Seroliya/zqcs-team-robotics/供电接线图.png

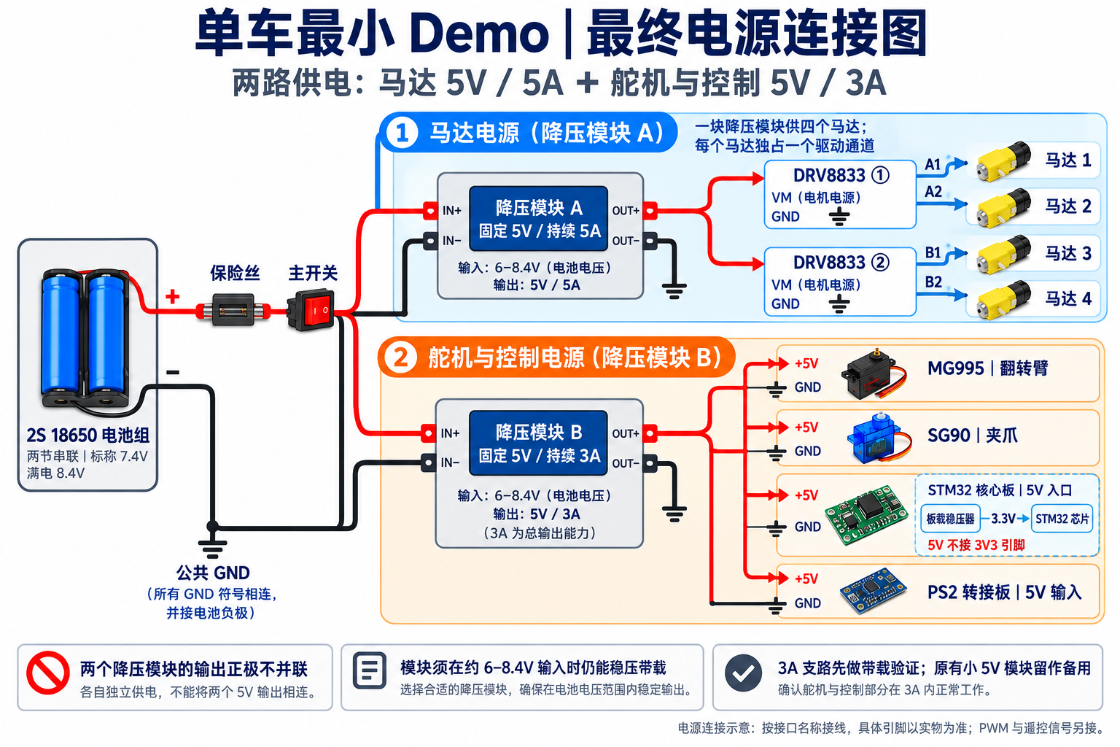
供电接线图.png
