Seroliya/zqcs-team-robotics/tmp/sources/image2.png

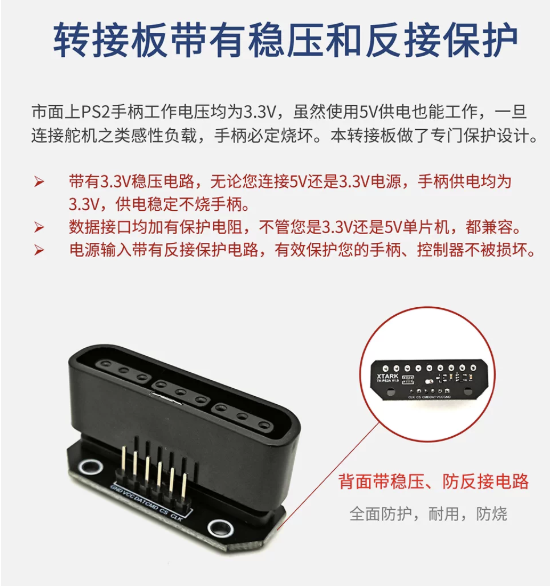
tmp/sources/image2.png
