Seroliya/zqcs-team-robotics/PROJECT.md

# CRTC2026 小车项目

本文件是本项目的长期记忆，记录当前目标、已采用方案、依据、待验证事项与继续工作的入口。团队已确认参加**新生组**，采用**上层车推送、下层车收集**的分工；先验证基础行驶与关键机械路径，再分别完善两辆车。

**2026-10-03 最终双F103分工（未改固件/未烧录）：**用户纠正为“一块32控制两个驱动板”：A主控仅读PS2与处理其他控制，经USART2 PA2/PA3交叉向B底盘发送四轮目标；B一块F103C8T6控制两TB6612双路板和四MG370全部通道。此前把两F103各控制两电机理解为用户选择，是误解，原图文已被替换。用户随后明确选择13PPR霍尔：底盘M1左后编码器TIM2 PA0/PA1、M2右后TIM3 PA6/PA7、M3左前TIM1 PA8/PA9（均4倍计数），M4右前PB10/PB11，A相EXTI10双边沿2倍计数；各轮按独立counts_per_rev换算。TIM4 PB6–PB9输出四PWM；方向分别PB0/PB1、PB3/PB4、PB5/PB12、PB13/PB14，PB15共控两驱动STBY；PB3/4须关闭JTAG保留SWD。主控PS2 PB12–PB15，可选TIM4 PB6–PB9四舵机PWM，传感器预留I2C2 PB10/PB11；两板同名GPIO互不冲突。电池暂保持原两串18650，升压12V；独立5V供两核心板5V输入及PS2，B.3V3供两驱动VCC，两板3V3不互并、所有GND共地。用户升压截图7.4→12V仅1.5A，小于四MG370额定工作点4.4A，TB小板电流/散热也不足；控制资源方案可行，动力升压需更换、驱动需升级或受控验证，电池/电池盒能力未核实。四节2S2P只是后续询问备选，电压仍7.4/8.4V，不表示正式采用。新规划替代旧单板8PWM接线，见[接线说明](sample-mecanum-car-study/docs/DUAL_F103_CHASSIS_WIRING.zh-CN.md)及[逐接口信号图](sample-mecanum-car-study/docs/figures/dual-f103-signal-ports-20261003.png)、[逐接口供电图](sample-mecanum-car-study/docs/figures/dual-f103-power-ports-20261003.png)。当前固件仍旧TT开环，未实现新编码器/PID/通信/使能；TB标准PWM低电平短路制动，不能照搬旧双输入PWM的00滑行停车。本轮仅提交图片与方案文档，未改固件或烧录。

**2026-10-03升压候选复核：**新截图标称30W MAX、输入9A MAX，芯片型号未确认。12V下按30W预算最多2.5A，不能覆盖四MG370标称额定工作点52.8W/4.4A；两块分别供两电机时每组26.4W，只剩3.6W最大功率余量，持续输出、低电压、起步和温升均待验证。两升压输出不得直接并联，TB6612电流/散热瓶颈独立存在。图中升压保持选型待核；并未决定采购。两张图用矩形模块逐接口表达，并保留SVG、生成脚本及端口清单。

**2026-10-02历史单板草案（已被10月3日双板方案替代）：**用户希望整车约2kg爬坡，允许更换平台、轮子与供电，优先整套性价比；本次明确按两块普通TB6612FNG双路板规划，电机为尚未购买的MG370。ADB手机截图确认所看商品为12V、减速比34.014、额定1.1A/1.5kgf·cm/260rpm、堵转6.2A、96g，两种霍尔/GMR版本同表，实际编码器选项未确认。两TB电压/逻辑可接，但连续负载散热和电流余量不足，未认定为2kg爬坡匹配；普通XL6009不作为四轮升压动力首选。新接线规划见[MG370与两TB接线](sample-mecanum-car-study/docs/MG370_TB6612_WIRING.zh-CN.md)：沿用现有8路双输入PWM，TB的PWMA/PWMB保持3.3V高，后续PB5共控STBY需新增代码；四轮低线数霍尔拟用A相EXTI、B相判方向，PB3/PB4需释放JTAG保留SWD，PA11/PA12占用USB数据且需检查板载上拉。预留PA4/PA5 ADC、PA9/PA10 UART、PB6/PB7 I2C舵机扩展。GMR不能未经脉冲率核算直接套此中断方案。当前板上仍为原DRV8833/TT开环麦轮固件，未加入编码器/PID/舵机或PB5使能，未烧录；胶轮需改混控，换电机需重验极性和弱反转急停。

**MG370供电规划补充（延续两串升压路线）：**用户随后明确当前路线是两节18650串联升压到12V，再接两块TB6612的VM；三串电池仅为备选，不替代用户选择。主控/PS2从电池支路降压5V，TB逻辑VCC及PWMA/PWMB保持3.3V。按四只MG370商品额定1.1A预算，12V输出需要4.4A/52.8W，两串7.4V、效率85%时输入约8.39A，尚不含起步及外围；普通XL6009的4A开关电流不意味着可输出12V4.4A，因此升压路线可以规划，但具体模块与两TB负载能力均未验收。接线文档已按两串升压主方案更新。

**当前阶段：结构、供电与信号接线设计。尚无已验证的整车或正式加工图；已有固件源码与构建入口。** “最终电源图”表示本轮讨论选定的连接方案，不表示已经通过实物测试；信号图为建议引脚分配。

**本次版本整理与PR已完成：**本地开发分支`local/chassis-tuning-20261002`，四个底盘版本检查点及基础版标签已建立；当前已烧录固件对应`chassis/scurve-stop-20261002` / `c14c55a12e232da9e4421bd50c9f4b458ddf6aa5`，从该提交重新编译与板内11220字节读回一致，四份登记HEX也逐份校验通过。开发分支已推送Ehicy/zqcs-team-robotics fork，最新[PR #2](https://github.com/Seroliya/zqcs-team-robotics/pull/2)面向Seroliya主仓库main，创建时open、非draft、可合并，尚待审核。GitHub连接器创建PR返回集成403，随后使用本机Git现有GitHub认证创建成功，未输出或保存凭证。PR已附到本任务，操作与回退见[版本索引](sample-mecanum-car-study/docs/LOCAL_VERSIONS.zh-CN.md)。用户已得到可以接回VM试车的说明；本次不再暂停/复位板子，起步和急停实车效果待反馈。

**当前11220字节固件已烧录并独立校验（2026-10-02）：**用户要求曲线起步，明确选择松杆和START都反向急停。恒定满幅0.5s五次S曲线，小幅按比例缩短、最低80ms，公共斜率限幅375；行驶增幅200/减幅1000，直接换向先零输出等待40ms。正常模拟帧急停撤驱动20ms，再按此前PWM相反方向的10%输出，名义窗口30ms，最后输入1/1短路制动100ms；此前最大PWM低于30%只制动，静止无脉冲，重复请求不延长，错过窗口跳过。数字/无效帧、非法值、上限0和Flash操作前直接0/0；START需制动结束且松键回中再启动。保留25/50映射、前100/后95及v2校准。没有测速/电流反馈，不是真PID；主循环推进时间，没有独立硬件关断，调试暂停可能保持PWM。主机测试和Arm GNU构建通过，BIN11220字节、静态RAM216字节，SHA256 `85176ba39d1296b4b057c45fa87d599adbf466edaceac04dd54cf99cb250b4cd`。用户确认两块VM断开后，ST-Link37FF71064E57343655231443以100kHz NORMAL/SWrst备份64KiB，与上一版10036字节前缀相同；下载Verify、复位运行、独立读回11220字节完全一致。读回时0x41/ready0、72MHz、前100/后95、cap100、四轮目标/软件输出和八路CCR全0，stop idle/startup inactive；校准页旧v1两记录保留且未加载，loaded0/dirty0，前后页字节一致，最后-run已恢复。用户随后按MODE并回中，但补充HOTPLUG未检测到ST-Link，不把切换后0x73当已确认。已告诉用户可以测试、先关电源接回VM再上电，不继续暂停板子。固件`sample-mecanum-car-study/build/s-curve-brake/`，证据`backups/curve-stop-20261002-01/`，说明[S曲线与急停](sample-mecanum-car-study/docs/S_CURVE_STOP.zh-CN.md)。停车效果、电流温升待实测。用户要求整理以前的东西为本地版本管理：已从备份恢复7260、9820、10036字节三版源码，并逐版重新编译与旧BIN逐字节一致，建立chassis/openloop-20261002、chassis/learn85-100-v1-20261002、chassis/pad100-95-v2-20261002标签。当前S曲线版在local/chassis-tuning-20261002分支，标签chassis/scurve-stop-20261002；原main仍为远程已合并的31fe7ac。版本登记表含校验值、原始归档和诊断入口，见[本地版本索引](sample-mecanum-car-study/docs/LOCAL_VERSIONS.zh-CN.md)，重新编译证据在backups/local-versions-20261002-01/，四版HEX在releases/firmware。用户随后要求整理好后提最新PR，将本地开发分支推到Ehicy/zqcs-team-robotics fork并向Seroliya/zqcs-team-robotics main提PR。

**上一版10036字节固件已下载、校验并独立读回一致：**用户补充要求pad映射并搜索常规方案：查微软/Steam/WPILib及作者死区研究后采用左杆25%、右杆50%的线性+三次混合曲线（可在头文件调为0～100），左杆两轴共同增益保持死区处理后的方向，原120～136轴死区保持；无额外时间滤波。训练改为共用驱动映射，以实际横移/转向比例学习，线性横移30%进入门槛不变。256轴值和65536方向/左右杆独立性测试通过，手感未实车验收，说明见[pad映射](sample-mecanum-car-study/docs/PAD_MAPPING.zh-CN.md)。用户要求起步斜坡0.5秒，疑似横移补偿方向反了，要求调换并靠近原始状态。已改加速率200个百分点/秒、前/后横移100/95（原85/100反向缩小差值15→5）；减速1000、换向40ms保持。SELECT训练系数5→2、每次最多10→5点，普通驾驶仍不学习，SELECT+×恢复100/100。Flash记录版本升为2，旧版本1有效记录保留但不加载，避免旧85/100覆盖新默认；不在开机写默认值。全部主机测试和Arm GNU底盘构建通过，10036字节BIN/176字节静态RAM，SHA256 `6331dc87e8e58a16d7b2e40e61f22140c0537a79002a1cefb6720b259d5b5fec`。新版HEX在`sample-mecanum-car-study/build/strafe-front100-rear95/crtc-motor-front100-rear95.hex`；源码前后快照在`backups/strafe-near-baseline-20261002-01/`。用户回复“好了”确认VM隔离后，ST-Link37FF71064E57343655231443以100kHz NORMAL/SWrst连接成功（NRST未接），备份64KiB旧板内，旧代码与9820字节上一版一致；旧参数页版本1已有85/100序号0及100/100序号1。下载新版Verify、复位运行，独立读回10036字节SHA一致；板上73、ready1、72MHz、前100/后95、目标/软件输出/八路CCR全0，旧页原样保留且loaded0/dirty0，没有开机写默认值。最后读回已-run恢复程序。证据在本次备份目录，待用户关电源接回VM再上电回中试车。横移改善/纯旋转偏心未实测解决，本次未提交或推送。操作见[靠近原始状态的补偿](sample-mecanum-car-study/docs/STRAFE_NEAR_BASELINE.zh-CN.md)。

**2026-10-02 台架进展：**轮位和后轮极性已由用户逐轮确认，PS2程序已实测；较早已烧录摇杆连续调PWM、缓加减速和换向零输出等待的底盘固件。用户实机反馈前后正常，纯横移伴随圆弧转弯、车尾靠圆心，左/右移转弯方向相反，横移尚未通过；架空纯左移时左前/右后前进、右前/左后后退，四轮转向均符合且均在转。滚子安装与实际轮速/接地差异仍待核对，不能当作仅需反转横移符号。电流温升、起转阈值及右杆旋转验收结果尚未记录。操作和下载证据见 [TT开环调优说明](sample-mecanum-car-study/docs/MOTOR_TUNING.zh-CN.md)；本次电机支路改接两串电池的决定见4.1节补充，旧5V电源图不能作为本次VM接线依据。

**同日上一版固件已上板：**用户要求推测横移补偿、人工纠偏学习和Flash保存，确认没有IMU/编码器/模拟采样，又反馈手感黏糊。前/后轴横移默认85/100，加减速500/1000个百分点每秒、40ms换向零输出等待；只在SELECT纯横移训练时从人的小幅右杆纠偏学习，普通驾驶不学习，每次SELECT训练最多10个百分点。停车回中2s后保存，两次尝试间隔至少30s；START保留校准，SELECT+×恢复100/100。主机测试、Arm GNU三目标构建通过；最新9820字节BIN/176字节静态RAM已经ST-Link下载Verify、复位运行，独立读回一致（SHA256 `e63d2d344055c2d1e3ef1119b3c49d9bdac6eb4b5283ced4ea662627bd730ab8`）。板上模式73、回中使能1、72MHz、八路CCR全0。用户按SELECT+○后，F800页有序号0的CRC有效85/100记录，复位后loaded1/dirty0、参数相同、四轮软件输出0；实板写入与复位加载通过，保存的是试验默认值，尚未做实车学习或写入中断电测试。最新操作见 [人工辅助横移学习](sample-mecanum-car-study/docs/DRIVER_CALIBRATION.zh-CN.md)。烧录时用户仅断VM、主控与接收器仍供电；下一步关电源接回VM再落地比较横移，学习收敛、电流温升待实测。改动仍在本地未提交。

**本轮ST-Link诊断证据：**初始无法获取核心ID，用户重新插紧后100kHz NORMAL/SWrst连接成功，NRST未接；之后HOTPLUG正常。下载前64KiB备份识别了7260字节旧开环版（500ms起步/80ms等待），主循环平均12.68ms，未见停滞。先前整机断电、手柄未配对时模式0；用户说明电源上电后可配对，热读取确认73帧、回中127/128，不能把无供电/未配对状态当作代码错误。旧版和新版RAM地址不同，已分别使用匹配ELF。旧版诊断归档 `backups/stlink-research-20261002-01/`；最新烧录前备份、新源码和固件、下载校验、独立读回、参数页和复位证据归档 `backups/driver-calibration-flashed-20261002-01/`，见 [ST-Link诊断](sample-mecanum-car-study/docs/STLINK_RESEARCH_2026-10-02.zh-CN.md)。

用户进一步确认SELECT+○保存测试看到了双闪，保存LED提示已目视通过。当前待用户接回VM后的落地试验；烧录时已恢复程序运行，不继续在电机供电状态下暂停调试。

**上一版落地反馈（本版实车尚待测试）：**用户确认没有SELECT训练，只推右杆且左杆回中时绕车尾旋转，横移时车头偏移比之前更严重。85/100试验补偿未得到支持，先建议SELECT+×恢复100/100作为比较基线；不要继续以“前轴作用偏强”当作事实。源码纯旋转在横移为0时不使用front/rear横移参数，四轮机械目标为左侧同向、右侧反向且同幅；故纯旋转偏心不能归因于这项85%比例。实际轮速、滚子布置/几何和接地仍未测量，需整车俯视图及持续旋转现象确认，不能直接猜旋转增益。最新ST-Link尝试显示No debug probe detected，未读取新的参数，不推断板上已发生学习。随后已按用户要求改为100/95并加入轻度摇杆曲线，最新烧录状态见本文件顶部；此前100/100恢复确已保存版本1记录，但未记录该状态的实车比较结果。

后续工作先读本文件。用户的新指示优先；比赛约束以本地规则原文及后续官方修订为准。旧设计文档与本文件冲突时，使用本文件中的当前方案，不把历史建议恢复成要求。

## 1. 背景、目标与设计原则

- 比赛最终使用两辆车；团队成员是新手，优先结构简单、少采购、容易接线和调试。
- **上层车：**类似推土机，取消夹取与存取功能，目标是将挂架及中央黄块推落；先验证原底盘过150mm桥面的能力，再决定是否缩窄轮距，具体推板、拨片与轮组尺寸待定。
- **下层车：**保留 **MG995 翻转臂＋SG90 夹爪**的收集功能，由操作手操控接收上层掉落的黄块；接料口计划在收集仓上方安装**三面倒梯形收集网**，以较大的上口扩大接料范围并把方块导入仓口，具体尺寸待样块验证。
- 两车底盘沿用四个 TT 马达、两块 DRV8833、STM32 核心板与 PS2 手柄控制的基础方向。可复用电控与行驶验证结果，不再默认整车机械结构相同或直接复制。
- 首个上电 Demo 先打通供电与遥控行驶；同时提前验证挂架脱杆、台阶遮挡和下层接料路径。下层再验证翻臂、夹取与入槽；精确堆满 8 块不是首个 Demo 的前置条件。
- 电池尽量低置，臂根有独立承力支承；用实际负载验证稳定性，不能只凭三维外观判断可行。
- 电流规格分清“实际耗电”“堵转预算”和“电源输出能力”。不得把额外余量反复叠加成最小 Demo 的硬性采购门槛，也不得把模块商品标题当作已验证能力。

## 2. 文件与工程现状

| 路径 | 用途与状态 |
|---|---|
| [CRTC2026规则文档v1.0.pdf](CRTC2026规则文档v1.0.pdf) | 比赛约束原文；封面版本与正文版本标记有差异，引用时以具体条款为准 |
| [器材参数.docx](器材参数.docx) | 官方清单器材、参数与参考外形；清单数量不等同于已到货、已测量数量 |
| [PROJECT.md](PROJECT.md) | 当前项目记忆与决策入口 |
| [最终电源连接图](output/power/robot-demo-power-final-v1.png) | 保留翻臂与夹爪的下层车两路供电基线；上层车负载改变后须单独核对，图尚未更新 |
| [信号接线图（简洁版）](output/signals/robot-demo-signal-wiring-simple-v1.png) | 下层车接线建议；上层可复用行驶与PS2部分，舵机接口按实际机构确定；GPIO不是实物排针位置图 |
| [方块质量、导料与夹取核算](output/mechanics/block-gripping-study-v1.md) | 依据规则第13–17页的几何核算、摩擦敏感性计算、洞口与挂架取块限制；未经过实物验证 |
| [下方车底盘布局 v1](output/mechanics/lower-vehicle-layout-v1.md) | 基于255.8×149mm实物底盘的模块分区、翻转臂预留和布线方向；孔位及降压模块尺寸待实测 |
| [桥面通行试验CAD v1](output/mechanics/bridge-test-v1/README.md) | SolidWorks/STEP/STL，单段300×150mm，圆弧起拱15mm；10mm板厚及净高解释为试验假设，不是官方完整桥梁复刻 |
| [带高台试验装配 v2](output/mechanics/bridge-platforms-v2/README.md) | 两座300×300×300mm高台＋两段300×150mm试验桥，桥端升到300mm与台面齐平；SLDASM/STEP。沿用试验圆弧，不能用于官方130mm桥下净空验算，原v1保留 |
| [翻转臂与料仓CAD v2](output/mechanics/flip-arm-sw-v2/README.md) | SolidWorks零件及夹取/抬升/投料三姿态装配、STEP；夹爪为占位，安装接口及收拢姿态未定，不是整套加工完成件 |
| [舵机照片适配CAD v3](output/mechanics/flip-arm-sw-v3/README.md) | 根据pic实物尺照补MG995与SG90外形、SG90托架，修正MG995朝向及支架/底座对应孔；保留v2料仓与臂长，夹爪传动和腕部连接未完成 |
| [小车结构与接线方案.md](小车结构与接线方案.md) | **历史详细草案**；其三路供电、主动分料、9 块容量、4.8V 舵机电源及部分采购要求已被后续讨论替代。尺寸、引脚表仍仅供参考 |
| `tmp/sources/` | 文档提取、参考图片及早期三维演示检查材料；不是固件代码目录，不作为长期事实来源 |
| `backups/` | 旧文档备份，用于追溯，不代表当前设计 |

电控源码位于 `sample-mecanum-car-study/`。2026-09-24 已完成 DRV8833 电机驱动；保留 Keil/ARM Compiler 5 工程，新增 Arm GNU 构建入口，无 CubeMX 工程。详见 `sample-mecanum-car-study/docs/DRV8833.zh-CN.md`。不得把 `tmp` 中的可视化脚本当成机器人控制程序。

## 3. 必须保留的比赛边界

以下依据本地规则及前期读取结果；正式参赛前复核原文与最新答疑。

| 项目 | 约束及对设计的影响 |
|---|---|
| 初始尺寸 | 长宽高不超过 **260×190×200mm** |
| 展开尺寸 | 当前按规则允许的长宽高包络 **435×400×450mm** 路径检查，需包含机构运动范围 |
| 重量 | 上限 **2.0kg**；装载道具如何计入检录重量仍须核对官方解释 |
| 电池 | 使用 **18650**；每车一个供电模块，额定电压不超过 **7.4V**，电池组一个对外输出接口；接口之后再分两路降压 |
| 断电 | 正式比赛必须适配官方无线继电器，可遥控切断底盘电源。当前 Demo 图未画该组件，不能据此认为比赛可省略；型号和端子接法待确认 |
| 成本 | 新生组全队机器人总成本上限 **420 元**；无线继电器采购按规则例外处理。未完成当前方案的实际报价核算 |
| 桥与轮组 | 桥面约 **150mm** 宽，整车限宽 **190mm** 不等于轮子能获得桥面支撑。轮子外宽、实际接触位置与桥侧干涉都需验证 |
| 方块与携带 | 方块外形约 **40mm**，中心镂空约 **20mm**。携带要求道具随车运动；规则未明确要求封闭料仓或整车倒置后仍不掉块 |
| 对抗与强度 | 低速挤压与破坏性冲撞须区分；主动铲翻并未确认合规。正式检录包含底面朝下的跌落检查，具体按规则执行 |

料仓默认可采用**有底、带挡边的敞口结构**。不得把上盖、单向门、倒置保块当作本项目首版的强制要求。

## 4. 当前采用的电源方案

### 4.1 下层车器件与连接、上层车适用范围

下层车使用：4 个 TT 马达、2 块 DRV8833、1 个 MG995、1 个 SG90、1 块 STM32F103C8T6 核心板、1 套 PS2 接收器/转接板、1 组两节串联的 18650 电池。

本节两路供电图及两舵机电流预算作为**下层车基线**保留。上层车取消夹取与存取机构，不再默认配置这两只舵机；是否需要驱动可收起拨片的舵机尚未确定。上层保留马达与控制供电需求，待机构确定后重新核算B支路负载、模块与采购数量，不能直接照搬下层两舵机预算，也不能因取消舵机而取消主控供电。

用户已确认所查舵机工作电压为 **4.8–6V**，因此当前统一使用固定 **5V** 供电，不再要求舵机支路必须调到 4.8V。

**2026-10-02 本次台架接线覆盖：**用户认为5V动力不足，明确选择两节18650串联直接接两块DRV8833的VM（标称7.4V、满电8.4V），并接受TT超过此前所报3–7.2V范围；这不是本批TT耐压/温升验证。换接前拆除VM原5V正极线，不并接两个电源正极。STBY仍接STM32的3.3V；主控、PS2与将来舵机仍按各自规定的低压供电，不接8.4V逻辑脚。每块驱动板接一个GND即可，但电池负极、两板、主控和PS2必须共地，主控单独由ST-Link供电时也如此。用户随后反馈了实机行驶，端电压、电流和温升未测；该决定只覆盖本次测试，未将两车正式电源图与舵机预算改为已验收结果。以下5V马达支路及图为此前下层车基线。

| 支路 | 下层车原基线模块 | 负载 |
|---|---|---|
| A：马达 | **固定 5V、持续 5A** 降压模块 ×1 | 两块 DRV8833 的 VM，四个 TT 分别由四个独立 H 桥通道控制 |
| B：舵机与控制 | **固定 5V、持续 3A** 降压模块 ×1 | MG995、SG90、STM32 核心板 5V 入口、PS2 转接板 5V 输入；从模块输出处分支接线 |
| 备用 | 原有小 5V 降压模块 | 暂不接入；若共用 B 支路导致控制系统复位或掉线，再单独供控制系统 |

```text
两节 18650 串联：标称 7.4V，满电 8.4V
  正极 → 近电池保险丝 → 主开关 → 分电
                                 ├ A：5V / 5A
                                 │   ├ DRV8833① → 通道A接马达1、通道B接马达2
                                 │   └ DRV8833② → 通道A接马达3、通道B接马达4
                                 └ B：5V / 3A
                                     ├ MG995
                                     ├ SG90
                                     ├ STM32核心板5V入口 → 板载稳压 → 3.3V → 主控芯片
                                     └ PS2转接板5V输入
  负极 → 公共GND → 降压模块、驱动板、舵机、核心板、PS2转接板的GND
```

- 两个降压模块的**输入**接同一电池分电点；两个模块的**输出正极不得并联**。
- 电机的两根线接它所属 H 桥通道的两个输出端，不直接接降压模块，也不把其中一根线固定接公共地。
- 舵机和控制系统从 B 的输出端分别布线。舵机电流不经过 STM32 板、PS2 板或面包板；供电线与回流线要可靠。
- STM32 **核心板**上的额外稳压器负责 5V 转 3.3V，不能把“STM32 芯片本身”当成能直接接 5V。5V 不接 3V3/VDD 引脚。
- 器材资料写明核心板可从 5V/USB 供电，PS2 转接板有稳压功能；实际端子和板型仍须核对，不能凭示意图中的器件外观接针脚。
- 供电图描述此前5V马达基线；本次VM测试按本节10月2日覆盖说明。舵机 PWM、DRV8833 输入和 PS2 通信线见信号图及4.4节；PS2与轮位/极性已实测，整车动作和舵机尚未验收。

### 4.2 电流依据与适用范围

| 数值 | 来源与使用方式 |
|---|---|
| MG995 堵转电流 **1800mA** | 用户查得；尚未提供原始链接或实测记录，具体测试电压待核对 |
| SG90 堵转电流 **860mA** | 用户查得；同上 |
| 两舵机合计 **2.66A** | 1.80＋0.86，是采用上述数据的同时堵转预算，不是正常运行电流 |
| 控制系统预留 **0.15–0.30A** | 设计估算，未测量 |
| B 支路合计约 **2.81–2.96A** | 条件性预算：上述舵机数据适用于本机 5V 供电时才可直接使用。接近 3A，作为 Demo 试验方案，需验证动态电压与温升 |

堵转电流可用于相同电压下的最大稳态负载预算；不应把同一启动需求再重复相加。它不保证覆盖所有瞬态，也不表示器件可以长期堵转。此前 MG995 2.5A、SG90 0.8A 的估算不再作为当前预算依据。

四个 TT 的当前 5A 支路用于轻载、缓起步 Demo。前期同类 1:48 TT 参考样品在 6V 下空载约 0.16A、堵转约 1.5A；不是本批次在 5V 下的实测参数，不能直接断言比赛爬坡与顶推均足够。

DRV8833电流要按**每个H桥通道**与整板散热分别核对。TI在VM=5V、25℃条件下列出PWP/RTY封装每桥1.5A RMS、2A峰值，PW封装每桥0.5A RMS、2A峰值；这些不是任意红板双通道同时工作的保证值。本车具体封装、PCB散热、限流配置和TT实际电流仍未确认。截图所称“单板统一只有1.2A，两板共2.4A”没有对应板型依据，不采用为统一规格。5V/5A是电源供电能力，不强迫驱动板消耗5A，也不保护某个通道免于过载；四个电机分别走四个通道，不能把总电流当成流过单个通道。DRV8833有过流和过温保护，但不能据此允许长期堵转；也不能把正常启动或一次堵转直接判为必然烧毁。当前保留两板带四马达的轻载Demo方案，持续顶推能力须单独验证。

### 4.3 采购与验证原则

- 下层车沿用新增 **1 块 5V/5A＋1 块 5V/3A** 的验证方案；上层车按最终执行机构另核B支路，不再默认两车采购完全相同。采购、到货和模块具体型号均未确认。
- 要求模块在电池满电 8.4V，以及放电后约 6–6.4V 的测试条件下仍能稳定输出 5V。此处是验证区间，不是已确定的电池截止电压。
- “3A/5A”应对应模块实际持续输出条件；芯片最大开关电流、商品峰值与整板持续电流不是同一指标。
- **XL4015 官方输入下限为 8V**，不作为当前两串电池方案的默认选型；增加同款板数量不能解决输入电压不匹配。
- B 支路出现控制复位/遥控掉线时，先定位供电与接线问题，必要时启用原有小降压板单独供控制系统。A 支路实测能力不足时，才考虑拆成每块带两个马达。
- 用户选择先做Demo，再按实测决定是否额外增加滤波／储能电容；不把新增大电解电容一律列为首轮采购前提。上电前仍应核对成品驱动板已有芯片需要的外围元件：TI建议DRV8833的VM就近以至少10μF陶瓷电容接GND，VINT/VCP另有各自配套电容。系统供电图未画出这些元件不表示板上没有；缺失基本外围元件不能等出问题再补，额外储能电容是否足够也不能仅凭外观判断。
- 干扰判断区分欠压与过压：单纯短时欠压通常导致复位或通信异常，不代表烧毁；超过器件额定限制的尖峰可能造成永久损坏，不能把“最多只是STM32掉电”作为验证前提。保持共地并分别布置大电流回路，先轻载缓启停测试；出现复位、抖动或异常发热先停下定位，电压尖峰需示波器等适当测量方法确认。尚无本车瞬态测量结果。
- 电池、保护、主线或 DRV8833 限流/散热不足，不能靠增加降压模块修复。当前图不代表这些器件已验收。

### 4.4 信号接线

下层车采用[简洁版信号图](output/signals/robot-demo-signal-wiring-simple-v1.png)。上层车可复用马达与PS2信号分配，PB6/PB7不再默认接翻臂与夹爪，是否用于拨片执行机构待定。用户偏好简单、少装饰的接线图。图内各分区均连接**同一块 STM32F103C8T6 核心板**；引脚名称不表示排针物理顺序。以下分配利用芯片默认定时器映射，不启用对应定时器的引脚重映射；未确认实际核心板是否全部引出这些引脚。

| STM32引脚 | 连接端 | 信号方向／建议功能 |
|---|---|---|
| PA0 | DRV8833① AIN1 | 输出，TIM2_CH1 |
| PA1 | DRV8833① AIN2 | 输出，TIM2_CH2 |
| PA2 | DRV8833① BIN1 | 输出，TIM2_CH3 |
| PA3 | DRV8833① BIN2 | 输出，TIM2_CH4 |
| PA6 | DRV8833② AIN1 | 输出，TIM3_CH1 |
| PA7 | DRV8833② AIN2 | 输出，TIM3_CH2 |
| PB0 | DRV8833② BIN1 | 输出，TIM3_CH3 |
| PB1 | DRV8833② BIN2 | 输出，TIM3_CH4 |
| PB6 | MG995 的 S | 输出，TIM4_CH1，翻转臂 PWM |
| PB7 | SG90 的 S | 输出，TIM4_CH2，夹爪 PWM |
| PB14 | PS2 DI/DAT，接收器① | **输入**，接收器 → STM32 |
| PB15 | PS2 DO/CMD，接收器② | 输出，STM32 → 接收器 |
| PB12 | PS2 CS/SEL（也称ATT），接收器⑥ | 输出，低电平选中 |
| PB13 | PS2 CLK，接收器⑦ | 输出，由STM32提供时钟 |

- **驱动板：**①的A/B通道分别接马达1/2，②分别接马达3/4。GPIO接AIN/BIN输入，马达接各自AOUT/BOUT输出。3.3V逻辑满足DRV8833输入高电平门限；不能由此推断所有外围模块都支持相同电平。
- **2026-09-30 轮位实测：**×=电机1左后、○=电机2右后、□=电机3左前、△=电机4右前。用户确认电气正向时前轮前进、后轮后退，小车代码将1/2乘-1、3/4乘+1；用户确认滚子俯视O/菱形。实际轮心轴距与轮距未测，旋转符号暂按轴距大于轮距，整车平移和旋转待落地验收。
- **nSLEEP：**运行时必须为高电平；芯片本身有下拉，不能默认悬空也能运行。先查实际驱动小板是否已上拉或固定接高；若需外控且不存在板载固定电平冲突，可预留PA8控制两板。未确认板型前不将该可选线画成必接线。
- **舵机接口：**按用户照片，G是黑色或棕色、V是红色、S是白色或橙色。两种线色不强行对应到具体舵机型号。V接B路5V，G接公共地，S分别接PB6/PB7；舵机供电电流不经过核心板。PWM可从50Hz开始，脉宽和行程按实际机构校准；3.3V控制信号是否被本批舵机可靠识别需实测。
- **PS2接口：**按用户照片的接收器正面朝向编号，④为GND、⑤为VDD，③⑧⑨未使用。9针插座编号不能直接当成6针转接板排针顺序，应按转接板丝印对应DAT/CMD/SEL/CLK/GND/电源入口。
- **PS2电源：**用户照片写接收器VDD允许3–5V；《器材参数.docx》中的转接板资料另写有板载3.3V稳压。当前按B路5V接该转接板电源入口，再由其稳压供接收器⑤VDD 3.3V绘图；不把接收器⑤误标为转接板5V入口。实际板型不同应重新核对。资料所称保护电阻不等同于已证明具有电平转换，DAT实际电平及上拉配置仍需确认。
- **固件预留：**PA13/SWDIO、PA14/SWCLK留给下载调试；没有第三只分料舵机。PS2先可用GPIO模拟通信，确认协议时序后再决定是否用硬件SPI；马达PWM使用TIM2/TIM3，舵机PWM使用TIM4，避免将马达频率和舵机帧频混用。
- **接线验收：**所有模块共地；下层逐根核对14根主信号线及驱动使能状态，上层按实际安装机构核对，再分别测试马达、已安装舵机和手柄。图纸核对完成不等于已完成上电验证。

### 4.5 车内接线与模块底板（建议，未定案）

用户指出车内空间有限，散线整理及公共地连接困难。当前建议桌面单模块调试仍可手工连接，装车优先考虑简单的双层模块底板PCB：保留现成STM32核心板、两块DRV8833、降压模块和PS2转接板，用插座、端子及PCB走线集中连接；不是重新设计各裸芯片电路。用户尚未确认开始正式PCB设计。

共地表示各GND电气连通，不要求所有地线焊到同一个物理点。底板应提供连续、低阻的地连接，并按布局安排马达和舵机的大电流回路，避免经过核心板的细地线；A路5V与B路5V输出正极仍须分开。模块电源触点、铜线、过孔及端子都需按实际电流选型，不能认为铺铜后自然满足5A。

下层底板可集中两只舵机G/V/S接口、四个马达双线接口、PS2接口和SWD接口，并预留可选电容焊盘；上层接口按实际机构配置，是否共用底板待定。降压模块是否装在同板、板框大小和插座位置，须取得实际模块尺寸、引脚顺序、安装高度以及各车底盘可用空间后确定；目前没有可制造PCB文件。

## 5. 机械方案的当前状态

**2026-09-21舵机实物依据：**`pic/`中8张尺照确认TIANKONGRC MG995与SG90。MG995主体沿用40.5×20mm，含耳长按约54.5mm；SG90主体按约23×12mm、含耳长约32mm拟合。照片有视差，壳高、凸台、耳位和孔距的具体建模值见v3说明，不记为精密实测。v3保留现有仓容与高度，补两只舵机外形及安装接口；未据照片确认舵盘花键/孔位，也未完成SG90至夹指的传动。

**2026-09-18当前建模基线：**下层单车目标容量12–16块，料仓与149mm底盘同宽，后部及侧部接料；停车d3时车头朝a3。收集网为后装二号方案，当前建模不含网。用户确认车轮外径60mm，要求仓下保留面包板及一层元器件空间，不因层层叠加估算余量推翻原布局。v2暂用底盘上表面离地35mm、电控高25mm、仓底内面离地68mm、内仓180×143×80mm（仓沿148mm）；这些高度为可调整建模值，不是实测。臂轴离地110mm、臂板孔距130mm、名义夹持半径150mm；提供三种工作姿态。旧v1及下述早期布局仅作参考，仓底25–30mm不再采用。待实际接口确定后细化，未验证初始收拢包络和满仓桥下通过。

**2026-09-17 用户确认的分工：** 上层车改为推土机式推送车，不保留夹取和存取功能，目标是推落挂架与中央黄块，轮距较窄；下层车保留翻转臂＋夹爪收集功能，并由操作手操控接收掉落黄块。原两车统一夹取与储存的方向被替代；原三维模型不能作为当前加工依据。

**用户补充的接料方向：**下层三面收集网位于收集仓/料槽正上方，外形为上大下小的倒梯形导入网，上口扩大接料范围、下口对准仓口；不是沿底盘边缘设置的围网。三面的具体朝向、网材、网孔、张紧程度、支架尺寸及是否折叠尚未确定；不得将其记作已完成或已验证的机构。

**下方车底盘首版布局：**以用户实测255.8×149mm底盘为准，底板层采用“车头机械、中央电源、车尾控制”的分区。照片左端暂定义为车头，前部预留约70×95mm翻转臂臂根及运动通道；双节18650盒低置中央；两块DRV8833靠左右两侧马达；STM32和PS2放车尾并让插拔端朝外。收集仓和倒梯形三面网位于底板中后部上方，与电控形成上下层；建议四立柱通过两条转接梁锁到底板原孔，收集仓可拆，不让网架或落块直接压到PCB。具体坐标、安装与布线见[下方车底盘布局 v1](output/mechanics/lower-vehicle-layout-v1.md)。这不是已冻结CAD，降压模块、PS2整体、收集仓外廓和所用底盘孔仍待最小实测。

**建议的实现与操作方式，尚未定案或实测：**

- 上层中央块使用低位推板缓慢推向选定边缘；挂架块须沿杆推向自由端并完全脱杆，不能直接下压。研究固定推板配下探拨片/推叉，比较固定拨片与可收起拨片的通过性，再决定是否保留一只执行舵机。
- 协作优先试验“下层先对位停车 → 上层缓慢推落 → 确认接住再继续”。不把方块开始下落后追车接住作为可靠性前提。
- 下层围绕仓口上方的倒梯形三面网（机械臂一侧无网避免阻挡）研究接料结构：较大的上口拦截偏差，下口必须完整落在有底收集仓的入口内，不能让方块滞留在网兜、卡在网仓接缝或从前侧开口漏出。适度缓冲减少反弹，网面倾角与张紧程度通过样块试验确定；接料时翻臂避开网架与入口，夹爪负责地面收集及可达位置的漏接补收。
- 收集网需验证镂空方块的棱角、孔边是否挂网，以及网面下垂、边缘缝隙和连续落块是否造成滞留或漏接。网架计入初始与展开尺寸，并检查满载重心、场地碰撞、翻臂完整运动范围；三面网扩大接收容错，但不能代替对挂架下方台阶遮挡的验证。
- **挂架路径是关键待验证项：**按现有场地图，150mm长挂杆下方有向外约300mm的台阶，脱杆点可能仍在台阶上方。不能假设脱杆后直接落到地面车；须检查是否先落在台阶、下层接料口能否到达，以及是否需要引出台阶的导料结构。伸距、碰撞和展开尺寸一起核对。
- 上层窄轮距服务于桥面通行；区分接地点间距、轮外宽和整车宽。电池低置，验证边缘推块的偏心受力与侧倾，推送机构应允许车轮留在平台安全位置完成动作。

**仍未定案的部分：**

- 用户此前提出 **2×2×2 堆叠、共 8 块** 的目标；新分工下上层不设仓，下层目标容量及排列须重新确认，不把旧目标自动当作新方案验收要求。固定单轴翻转臂不能独立选择左右两列，不能承诺只靠投放角度就实现整齐 2×2×2。
- 助手提出过 **前后4×左右1×上下2** 的 8 块长槽备选，以及先验证单层4块再试第二层的顺序；用户尚未明确确认该排列，不能记作最终布局。
- 料槽倾角、挡边高度、净宽、实际容量、夹爪退出间隙及各投料角，均待样件验证。改变翻臂角度同时改变水平位置和高度，不是独立升降。
- 上层先测试原底盘过桥：用户确认轮胎外侧间距大于150mm、内侧间距小于150mm，具体数值未知。2026-09-18建立仅含中间桥板的试验CAD，验证部分胎面搭接及麦轮滚子接触稳定性后，再决定是否缩窄轮距。此前135/185mm是比较值，135–140mm不是已测尺寸或最终轮宽。下层轮距独立按接料和稳定性确定。
- 臂根约85mm、臂长约180mm、车体约250×185mm等均来自旧概念布局。简化机构后应重新检查，不能直接下单加工。
- 电池低置；分别检查空载、装块、抬臂时的重心与支撑范围。八块两层堆放对高度、重心和行驶保块的影响尚未验证。

上下层资源交接分工已确定，但推落顺序、落点、下层常态携带数量和最终仓容仍待验证。推土机式功能指推送道具，不意味着采用主动铲翻对手的机构。

### 5.1 方块、导料与取块路径的核算结论

详细公式、依据、假设和试验方法见[方块核算报告](output/mechanics/block-gripping-study-v1.md)。以下为2026-09-16核对本地规则第13–17页后的结论：

- **几何与质量：**规则图是六面开孔的立体框架，外40mm、孔约20mm，未倒角名义棱条宽10mm。用户确认PLA材质，但未给打印填充率、壁数和倒角尺寸。按全部棱条实心、无倒角、参考密度1.24g/cm³计算，体积32cm³、单块39.68g、8块317.44g。当前可用约40g/块作普通PLA的初步负载估算，不是实测值；此前30g仅为示例，不能作为已知质量。不能直接用40³−20³计算六面开孔框架，也不能直接用整块质量乘切片填充率。
- **摩擦：**导料槽材质未定。理想单底面接触时起滑要求tanθ＞μs，质量在判据中抵消。μs假设0.3/0.4/0.5/0.6时临界角约16.7°/21.8°/26.6°/31.0°；这些不是材料实测系数。先用真实样块及候选底板测倾斜起滑角，再确定角度。槽底连续平整，并验证方块孔边、接缝及多块相互卡住；倾斜槽不能自动保证2×2×2堆叠。
- **洞口取块：**规则写洞穴70×70×50mm、方块外平面齐洞口、径向居中；宽70、深70、高50mm是本次计算的轴向解释，仍应核对实物。左右薄夹指有空间：例如内开口50mm、两侧各4mm，外宽58mm。应夹实体棱、保持低位先直线退车约45–50mm，方块完全离洞后再抬臂；不假设底下有托钩间隙。进入部分包络、橡胶垫、连杆与姿态要一起验证，不能仅凭夹爪开口尺寸判定整机可行。
- **挂架取块：**杆直径14mm、长150mm、轴高250mm；图中块位于靠高台墙的杆根，下方有300×300mm、高150mm台阶。方块必须沿杆滑向自由端并完全脱杆，不能直接向上提。旧转轴高85mm、有效半径180mm在目标高度247–250mm时仅剩约72–78mm水平伸距，不能从地面直接跨过该台阶夹到杆根。必须先明确支承位置、接近路线、退杆行程及碰撞包络，不把臂加长到某距离当作已解决。
- **机构与总体布局：**旧稿曾有被动平行四边形保持夹爪姿态，下层是否保留尚未确认；刚性单臂的夹爪姿态随臂角变化，须检查洞内取块与入槽。上述旧夹爪挂架可达性结论保留作历史限制，新分工不再要求下层直接夹取挂架块。先完成上层推落、下层接收及夹取入槽的机械路径检查，再冻结各车PCB外形及连接器位置。

## 6. 工作流程、运行与验收

电控按基础 Demo 推进，固件目录为 `sample-mecanum-car-study/`：

**较早已确认上板的开环固件（2026-10-02）：**撤掉L1/R1调速，左杆控制平移方向与连续PWM幅度，右杆左右连续控制旋转；保留O形混合和后轮反向补偿。上电实际输出0、默认上限100%，四轮共同缓起步（200个百分点/秒）、减速（400个百分点/秒），需要换向时先降零并等待至少80ms。松杆、START、数字/无效帧立即撤驱动；START清空目标/输出/按键历史和灯态，松键回中后可直接推杆行驶。任一轮实际PWM严格超过60%才闪PC13，不是电流/温度报警。各轮增益100、最低PWM0，均未实测校准；本段参数属于7260字节历史固件，新源码响应和校准操作已由上面的最新记录覆盖。

上述版本主机测试与三个Arm GNU构建目标均通过；CubeProgrammer 2.23经ST-Link下载、Verify、复位运行成功，7260字节独立读回与BIN一致，SHA256 `7274982c39df1b1ffb018ecd7a099ba4e064fc2c6d57c4344730844dbc9b9ca3`。原板内64KiB与当时源码/固件保存在根目录 `backups/motor-openloop-20261002-01/`。RAM采样显示72MHz、循环/毫秒计数已运行，模式41、未使能、四轮目标/实际软件PWM0；实车须MODE切模拟73并松键回中。尚无单轮ADC电流/端电压采样、轮速闭环、软件限流、舵机动作或独立看门狗，接收器重复有效旧帧问题仍未解决。用户随后反馈前后正常、横移曲线偏航；尚无电流/温升实测。

9月30日的代码提交已通过PR #1合并，上游与本地main基线为 `31fe7ac76719a40012f6a5025287670614dedf07`；10月2日调优修改目前在本地，未另行提交/推送。以下下载记录保留作历史，不能用其中肩键操作或RAM地址指导当前版本。

- `hardware/Src/main.c`：PS2有效性、回中使能、按键与底盘主循环；`ps2.c`：手柄通信；`motor.c`：死区/麦轮混合；`pwm.c`：DRV8833双输入PWM。
- `motor_init()` 内部初始化TIM2/TIM3，电机输入按4.4节；20 kHz为72 MHz定时器时钟下的初始参数，停机采用0/0滑行。PS2也已按4.4节对齐；nSLEEP依赖硬件保持高，不启用PA8。
- 在该目录运行 `python tests/run_tests.py` 进行主机测试；Windows GCC缺少UBSan时先设 `$env:SANITIZE='0'`。运行 `python build_firmware.py --toolchain <Arm GNU bin目录>` 生成 `build/crtc-motor.hex`，用STM32CubeProgrammer经ST-Link/SWD下载及校验。Keil工程仍为 `user/rmcic.uvprojx`。
- 2026-09-24已用xPack Arm GNU GCC 15.2.1编译，经STM32CubeProgrammer 2.23.0/ST-Link烧录并校验、复位；独立读回5304字节一致。TIM2/TIM3运行、PSC=0/ARR=3599、八路CCR=0；采样时PS2无有效帧，电机与手柄联动尚未验收。日志见 `sample-mecanum-car-study/docs/FLASH_RESULTS.txt`。
- 2026-09-30在当前电脑用Arm GNU 14.3.1重新编译，主机测试全部通过；用已有CubeProgrammer/ST-Link烧录并校验，独立读回5412字节一致。已收到PS2模拟模式73、回中轴127/128，control_ready=1；回中时八路CCR为0。此前独立圆圈键翻灯示例已实测通过；小车主入口不包含翻灯或舵机动作。用户确认马达尚未安装，因此轮位、方向、机械运动仍待装好后测试。详见 `sample-mecanum-car-study/docs/FLASH_2026-09-30.zh-CN.md`；README末尾旧接线已更新为当前接法。
- 同日按用户最新指示，当前板上为独立 `motor-buttons` 四键满速测试：×→电机1、○→电机2、□→电机3、△→电机4，每次按下独立切换启停，运行时100% PWM，START全停，上电全停。按键接口支持数字41和模拟73，原小车摇杆接口仍只接受73。主机测试、烧录校验和4204字节独立读回通过；板上模式41、有效帧计数增加、armed=1，初始四路全停。详见 `sample-mecanum-car-study/examples/motor-buttons/README.zh-CN.md`，其中保留之前○键全开版本记录；实际轮位由用户逐键确认。
- 主机测试不能替代PWM波形、方向、温升和遥控失联实测。9月30日尚无起步/反转斜坡；10月2日已增加开环斜坡与换向等待，仍无轮速闭环、舵机动作和独立看门狗，接收器有效旧帧问题仍未解决。
- 当前板上已更新为O形麦轮摇杆版：左杆平移方向、右杆旋转方向，推杆幅度不控速；上电10%，L1/R1按下边沿减/加10%，范围0～50%，START全停后回中恢复。已核对下载包STM32F1参考代码的按键/摇杆位，主机测试及Arm GNU构建通过。用户插紧SWD后，CubeProgrammer下载、校验、复位成功，独立读回5736字节与BIN一致；板上模拟73、速度10、control_ready=1，回中八路CCR零。之前四键测试已备份在根目录 `backups/joystick-o-speed-20260930-01/`。整车平移和旋转待实测；50%为PWM上限，尚无电流检测。细节见 `sample-mecanum-car-study/docs/JOYSTICK_O.zh-CN.md`。
- 最新按键检查读取模式41、速度40%、最近松开按键11（R1）、control_ready=0、八路CCR零；R1调速已在实物生效，实际按键次数未记录。已提示切回MODE模拟73并回中；各调速边界及整车摇杆行驶待实物验收，不能将此前首次73回中读数当成之后一直有效。
- 随后用户明确目前纯ST-Link供电、没有电机电源，要求非初始速度时闪灯。已在小车入口增加PC13用户灯：10%灭，其他档（含0%）约0.5秒切换亮灭，不阻塞轮询。主机测试、构建通过；关闭占用ST-Link的CubeProgrammer窗口后备份、烧录、校验成功，5932字节独立读回一致。当前速度10、模式41、control_ready=0、八路CCR零、PC13输出高电平灭灯；须切73并回中才可通过肩键调档，新LED目视现象待用户确认。此前摇杆版备份在根目录 `backups/joystick-speed-led-20260930-01/`，详见JOYSTICK_O说明。电机转动还须给驱动VM供电，不能把纯ST-Link供电的程序运行当作整车行驶通过。
- **历史：9月30日最终肩键版。**用户确认前述测试“没问题”后要求正式底盘控制，上电0%、范围0～100%、L1/R1每按一次减/加10%、严格大于60%闪PC13灯；START全停并重置速度0、按键历史和灯态，松键回中后仍须R1加档才能行驶。已编译、测试、备份并烧录，5956字节独立读回一致（SHA256 `0cbed8ac1f5504737cb1ec99d0f585342967df16a19f6867cff86a1be6e7d472`）。采样速度0、模式41、control_ready=0、八路CCR零、PC13灭；行驶/调速须模拟73，START数字41也可复位。当时速度变量地址2000002C，已不适用于当前版本。备份在根 `backups/chassis-100-reset0-20260930-01/`，日志及使用见 `sample-mecanum-car-study/docs/JOYSTICK_O.zh-CN.md`；该固件已被10月2日调优版替代。

| 阶段 | 工作与验收标准 |
|---|---|
| 0. 推落与接料路径 | 复刻高台边缘、挂杆及下方台阶，用手持推片和接料口模型验证中央推落、沿杆脱出、落点与遮挡；记录接料成功和失败原因，通过后再冻结推板/拨片及接料结构 |
| 1. 实物核对 | 记录降压板型号、输入范围、持续电流条件，核对核心板与PS2输入端；确认电池、驱动板和线材实际到货情况 |
| 2. 电源台架 | 先断开负载调试/测量，再逐项接入。本次VM测试按4.1节10月2日覆盖说明，控制/舵机支路保持5V；負载动作时无反复保护、明显掉压或异常发热 |
| 3. 基础固件 | 确认开发环境和引脚；保留SWD调试。先完成PS2读取，再分别测试每个马达与舵机方向及行程。上电和遥控失联时应停止轮驱动 |
| 4. 行驶 Demo | 先架空轮子检查四通道，再轻载落地验证前进、后退和转向；缓起步，避免直接高速反转 |
| 5. 分车机构验证 | 下层先空臂、再带块验证夹取、抬升、释放与退出；上层验证推送、脱杆、退车及拨片通过性，检查推送受力和驱动温升；不长期堵转或顶机械限位 |
| 6. 电控联动验收 | 各车马达与已安装执行机构联动时，STM32不复位、PS2不掉线、舵机无异常动作；失败时定位电源/驱动/程序原因，不仅凭“电流够大”判断 |
| 7. 下层接料与存储 | 分别验证夹取入槽和三面收集网接收落块；覆盖入口中央、网面、边角及连续落块，检查挂网、滞留、反弹、缝隙漏块、翻臂与网架干涉、满载入口及行驶保块；记录停车偏差下实际导入承接区域的成功情况。容量按新布局确定，8块满仓不是首个Demo必达项 |
| 8. 双车与比赛完善 | 练习下层先对位、上层再推落的协作，验证漏接补收；分别核对两车尺寸、质量、官方遥控断电、强度和预算，上层重点验证窄轮组过桥、坡道及平台边缘稳定性 |

每次实测至少记录：供电电压、器件型号、负载/动作、输出端及负载端电压、测量方法、是否复位/掉线/过热。电流数据注明空载、典型负载或堵转条件；普通万用表平均读数不能当作捕获全部瞬态的证据。

## 7. 重要设计变更与未采用方案

| 历史方案或说法 | 当前处理 |
|---|---|
| 两车统一翻臂、夹爪和料仓，验证一辆后整车复制 | 2026-09-17改为上层推送、下层收集；上层取消夹取与存取，采用较窄轮距，下层保留翻臂＋夹爪并接收落块；基础电控可复用 |
| 三路供电，逻辑始终独立 | 当前Demo采用两路，舵机和控制合并；原小板留作故障排查/恢复独立逻辑供电的备用 |
| 舵机支路必须可调4.8V、必须5A | 用户确认舵机支持4.8–6V；改固定5V。按用户提供的堵转参数，先用真实3A模块验证 |
| 马达必须6A持续、8A峰值 | 不作为最小Demo硬门槛；当前5V/5A轻载验证，测量后再决定是否调整 |
| 每车买3块大降压板，两个马达分一路 | 曾讨论的备选；当前仍是一块供四马达，另一块供舵机和控制 |
| 回转导流斗＋第三个舵机＋三条料道，每车9块 | 因复杂度过高被简化方向替代；下层保留MG995与夹爪SG90，料仓排列未冻结；上层不设料仓，拨片是否需要舵机待定 |
| 封闭仓、单向门、倒置不掉块是必需条件 | 已撤回；默认可做有底有挡边的敞口料仓 |
| 改变车头方向能改变夹爪相对车上料仓的投放位置 | 不成立；二者随车一起运动。需改变机构相对位置或依靠导料结构 |
| 4×1×2长槽已经被用户选定 | 未确认，只是针对单轴翻臂提出的备选，不得覆盖用户最初2×2×2的讨论目标 |
| 85mm臂根＋180mm臂能升到250mm，所以能取挂杆方块 | 高度判断遗漏150mm台阶和杆根位置；撤回“已能取”的结论，先验证接近路线、沿杆退出及完整碰撞包络 |

## 8. 后续维护与核对入口

- 新采购、接线、引脚、实测和机械布局确定后，更新对应章节，清楚区分“用户提供”“资料参考”“计算估算”“实物验证”。
- 仅保留影响后续工作的决策，不把搜索过程、图像修改过程和临时尝试写成流水账。方案替代时更新正文，并在设计变更表保留简短理由。
- 固件/CAD建立后补全实际文件结构、工具版本、构建/下载步骤和验收记录入口。文档、源码完成、编译/下载成功与实车运动验收须分别记录，不能相互替代。

可复核的一手资料：

- [ST：STM32F103C8](https://www.st.com/en/microcontrollers-microprocessors/stm32f103c8)：芯片电源与接口范围；不代替具体核心板原理图。
- [ST：STM32F103x8/xB数据手册](https://www.st.com/resource/en/datasheet/stm32f103c8.pdf)：表5核对GPIO与默认定时器功能，用于4.4节建议分配。
- [TI：DRV8833](https://www.ti.com/product/DRV8833)：驱动工作范围、封装和电流能力；不代替所购小板散热与布线能力。
- [TI：DRV8833数据手册](https://www.ti.com/lit/ds/symlink/drv8833.pdf)：输入高电平门限、nSLEEP及H桥端子定义。
- [XL4015官方资料](https://www.xlsemi.com/datasheet/XL4015-CN.pdf)：输入范围从8V开始。
- [Adafruit：1:48 TT参考样品](https://www.adafruit.com/product/3777)：参考电流实测；不是本批次马达证明。
- [Pololu：电机与电源选择](https://www.pololu.com/docs/0J73/4.1)：堵转、启动与反转瞬态的区别。

用户提供的MG995 1800mA、SG90 860mA参数仍等待商品资料或实际测量补充，不能拿其他型号、不同版本舵机的参数冒充已确认值。
