Seroliya/zqcs-team-robotics/小车结构与接线方案.md

# CRTC2026 新生组双车结构与接线方案

本方案面向采用翻转臂和夹爪的两台遥控机器人。两车统一底盘、轮组、翻转臂、料仓与接线，通过驾驶分工分别处理中央高台和地面资源。每车料仓9块；一号车通常携带5–6块，二号车按任务携带6–9块，不以满仓为目标。每车采用三路供电，原有小降压板仅供控制系统。本文是可用于原型制作的总体设计，不是已通过实物测试的加工图。孔位、器件批次电流、方块重量和摩擦系数尚须测量。

依据：项目内《CRTC2026规则文档v1.0.pdf》（封面 V1.0，正文另标赛事规则 ver1.4）和《器材参数.docx》，用户已确认参加新生组。比赛约束以所提供文件为依据，未取得后续官方答疑修订。

## 1 规则决定的设计边界

| 项目 | 文件要求 | 本方案处理 |
|---|---|---|
| 初始外廓 | 长宽高不超过 260×190×200 mm，PDF 第6页 | 两车整车目标250×185×≤190 mm，轮组最外侧宽135–140 mm |
| 展开外廓 | 可选择任意状态≤435×400×450 mm，或规定球体包络 | 选第一种，设计目标≤420×200×310 mm；需核对夹爪、线束和完整运动扫掠 |
| 重量 | 不超过2.0 kg | 空车目标1.1–1.35 kg；按装块后≤1.7 kg设计，留动态余量；装载是否计检录重量仍按官方解释执行 |
| 电源 | 18650；每车一个供电模块；额定电压≤7.4 V；模块只有一个输出接口 | 两节串联2S，额定7.4 V、满电8.4 V；电池组只有一个对外输出，之后分配三路降压 |
| 断电 | 必须适配官方无线继电器，至少能遥控切断底盘电源 | 优先让继电器切断全部执行和控制支路；接收部分按其说明保持可恢复供电 |
| 成本 | 新生组全队机器人总成本≤420元；无线继电器采购例外 | 保留控制、驱动和舵机；通过替换底盘而不是不断叠加采购控制总价 |
| 携带 | 与机器人接触，在重力环境下沿前后、左右、上下方向均可跟随其运动；结束时判定并立即断电 | 采用有底、有四周挡边的敞口分道料仓；规则未要求封闭或整车倒置不掉块。正常姿态断电后仍应保持方块随车移动 |
| 强度 | 检录150–200 mm底面朝下跌落无零件掉出；中期展示180 mm | 电池硬限位加绑带，底盘螺接，臂根承力限位，线束固定 |
| 对抗 | 低速挤压允许；恶意冲撞、破坏和持续固连受罚 | 只将圆钝承力面用于低速顶推；主动铲翻不作为已确认合规的功能 |

桥面只有150 mm宽，轮组不能只满足190 mm整车限宽就认为能过桥。本方案把轮组最外侧宽控制到135–140 mm，让每个轮子都尽量获得完整支撑；上层车身可宽于桥面，前提是桥侧无干涉且桥端通行包络足够。不能把“整车宽必须小于150 mm”当作规则原文。规则提到桥梁净高130 mm，不能据此假设一台190 mm高的车可以从桥下通过。坡比0.5对应约26.6°，普通60 mm轮不能直接爬150 mm垂直台阶。

官方底板标称255×150 mm，并带5–10 mm测量误差。它不是装轮后的外廓尺寸；前后长度也只剩很小余量。优先检查能否用两车相同的内移电机支架和必要的轮槽保留底板。若内收后的车轮碰板、电机互碰或开槽损害强度，则两车统一换自制骨架。不能通过压短轮毂或让轮子刮板实现“收窄”。不推荐整体抬高底盘躲轮子，因为会抬高电池和重心。

## 2 双车结构与布局

| 项目 | A 一号车 | B 二号车 |
|---|---|---|
| 主要任务 | 从高台启动区过桥，收中央黄色核心和周边白块 | 地面白块、洞穴黄色核心、物资架黄色核心 |
| 建议整车初始外廓 | 250×185×≤190 mm；保留255 mm原板时总长须实测≤260 | 同左 |
| 轮子 | 现有60 mm麦轮，四轮独立驱动；坡道牵引不合格再评估两车统一改普通橡胶轮 | 同左 |
| 轴距目标 | 160–170 mm | 160–170 mm |
| 轮中心横向距离 | 约105–110 mm，按轮组外宽135–140 mm、轮厚约30 mm反推 | 同左 |
| 中部底面离地 | 22–25 mm目标，避免坡顶托底 | 同左；低位推板必须能收起 |
| 料仓 | 3条料道，每道3块，共9块 | 同左 |
| 臂根轴心高度 | 约85 mm | 同左 |
| 臂根到夹持中心 | 约180 mm | 同左 |
| 驱动与舵机 | 4 TT、2 DRV8833、1 MG995、2 SG90 | 同左 |

以上尺寸是设计目标，不是现有底盘孔位。先用电机和车轮实物做一套排布样件，验证后复制第二套；若TT机身相互干涉，可在前后安装位置适度错开，但不能把轮支撑宽度做成“纸面135 mm”。每侧内移量=(原轮组外宽-目标轮组外宽)/2，例如原为200 mm、目标140 mm时，每侧需内移30 mm，并非只移5 mm。上部料仓宽142 mm，可跨在轮子上方；轮顶附近仓底须留5–10 mm运动余量，低位电池仍在两侧轮子之间。

自下而上布置：轮轴附近的电机与底盘骨架；中部低位电池和电源板；后部料道；前部双侧臂根支架。电池靠近轴距中心略向后，不能放在料仓顶上，也不能为配重无条件堆到车尾。接收器远离电机和金属遮挡，控制板位于有绝缘盖的可维护区域。

135 mm轮外宽在150 mm桥面上，居中时每侧只有7.5 mm几何余量；140 mm时为5 mm，不能视为宽裕。两车采用相同的桥上低速直行模式、关闭横移、缓起缓停，收臂后通过。先在贴地150 mm宽样桥上完成空载与满载测试，成功后才上正式高度。两车均不在桥上顶推；一号车优先用桥，二号车通常走地面，避免相向会车。

## 3 翻转臂与夹爪

### 3.1 受力结构

使用左右两片臂板、贯通转轴或同轴支承，MG995安装在根部通过舵盘或短连杆驱动。轴的径向力由两侧支架承受，不能把整条臂悬挂在舵机输出轴上。支架通过螺钉连接底盘纵梁。打印件沿主要受力方向布置，臂根和螺孔加筋，转轴螺纹不要直接作为长期摩擦面。

增加轻型被动平行四边形连杆，保持夹持器在翻臂过程中基本不翻滚，便于对正方块及进入导流斗；不额外消耗舵机。它仍需对限位、干涉与折叠奇异位置进行全行程检查。

设置三个结构位置：地面夹取位、空载收纳位、低位承力位。低位承力位的臂板后表面压在底盘挡块上，前端另设宽而圆钝的推面。推力路径为推面→双臂/支架→挡块→底盘，不经SG90夹爪小齿轮。收纳位有支撑托，减少行驶振动负担。机械限位外还须设置软件限位，舵机不应长期顶着挡块通电。

### 3.2 几何检查

以B车为例，臂根沿车长位于距车尾约200 mm、离地85 mm处；夹持中心半径180 mm。坐标满足 x=200+180cosθ、z=85+180sinθ，θ从朝前水平线算起。

- 夹持中心离地25 mm时，θ≈-19.5°，x≈370 mm；加上爪尖后展开长度目标仍小于420 mm。
- 夹持中心离地250 mm时，向前水平距离约72 mm，可对齐物资架；必须沿挂杆朝自由端退块，不能垂直硬扯挂杆。
- 收纳角约154°时，夹持中心约(38,164) mm；夹爪上方预留约20 mm后仍可控制在190 mm以内。
- 从地面位到收纳位约173.5°。实际MG995行程和舵盘零位需标定，若实物不足，不可加大脉宽强顶，应修改连杆传动比或收纳姿态。
- 最高夹持中心约265 mm；加上夹爪、连杆和线束后检查总高与扫掠空间。两车使用同样的180 mm臂和相同角度标定流程。

这些是中心点运动校核，尚不能替代实体碰撞检查。进料时停在料仓车头侧入口上方，减速、短暂停顿后松爪；料仓挡边和导流斗应避开双臂扫掠。

### 3.3 夹爪

一台SG90驱动对称双爪，最大净开口约50–54 mm，爪指厚约3–4 mm，闭合目标由40 mm实块与软垫压缩量标定，不能靠堵转保持。软垫贴在方块外侧实心框边，避开20 mm镂空中心。根部短杠杆与对称连杆优先于很长的直驱舵盘。

针对70×70×50 mm洞穴，伸入部分总宽目标≤64 mm、高≤44 mm，SG90本体留在洞外；指尖可加2–3 mm圆钝承托台，减轻纯摩擦夹持需求。针对10 mm高矮墙，把夹持接触区设在距局部支撑面约15–30 mm处，爪指不要伸进31.5 mm墙缝后撑坏结构。洞口和矮墙都需用实物模型验证。

### 3.4 扭矩核算与对抗边界

示例按B车夹爪组件80 g、两臂及连杆等100 g、方块30 g、有效臂长18 cm估算，最不利水平姿态静力矩约：

T = 0.08×18 + 0.10×9 + 0.03×18 = 2.88 kgf·cm。

这只是估算，方块质量未给出；加速度、摩擦和冲击会增加需求。MG995在4.8 V的约9.4 kgf·cm为器材文档参考堵转扭矩，不能当连续工作扭矩。原型目标把经常出现的静力矩控制在实测堵转扭矩的约1/3以内，并以温升与动作余量验收。

若抬举相当于1 kg的对方载荷，18 cm力臂就需要约18 kgf·cm，已明显超过该参考堵转能力。因此本方案不承诺MG995能掀翻对方。其兼用功能是落到限位后的低速顶推和圆钝低位导向。若尝试用楔面让对方轮子短暂减载，必须先确认裁判对具体结构和动作的解释；不加速冲撞、不夹住对方车体、不使其跌落高台。

麦轮横向容易被推移，并不适合以大推力为主要战术。优先靠拾取与保分获胜，而不是提高驱动电流追求强行顶翻。

## 4 分料与断电保块

### 4.1 携带判据与料仓形式

PDF第17页的定义是：物体与机器人接触，且在重力环境下沿任意方向（包括前后、左右和上下）均可跟随机器人运动，即视为携带；判定节点为比赛结束时。该条没有规定料仓必须封闭，也没有规定整车翻转或倒置后物体仍不得掉出。

据此，本方案采用敞口料仓作为默认形式。正常姿态下，仓底支撑方块、四周挡边使其随车前后左右移动，抬起和缓慢降低机器人时也可随车上下移动；这种结构有合理依据满足定义。无底框仅把方块围在地上，抬车时方块留在地面，才是明显不同的情况。这里是对所提供规则文本的解释，不冒充另有官方答疑。

断电是需要考虑的真实比赛状态，但不意味着必须封闭。敞口仓依靠仓底和挡边留块，本来就可以不依赖电力。上盖、止退门和倒置不掉块均属于可选可靠性增强，不列为规则要求或首版必做项。此前将这些措施作为必需条件的设计已撤回；完整翻转保块测试亦不作为基础验收条件。

### 4.2 敞口分道结构

固定翻转轴只决定一个主要投料区域。移动整车、改变车头方向不会改变夹爪相对车上料仓的位置，不能解决堆料问题。单纯加大箱子也不能保证自行铺满。

推荐两车都使用“顶部接料口＋SG90分料导流斗＋三条敞口倾斜料道”，并在四周设置挡边。SG90只转动轻导流件，不移动满载料仓。第一块滑到料道末端，第二、第三块依次排在其后；在不同料道之间交替分配，避免所有载荷偏一侧。顶部开放降低落块时的干涉，也便于观察堵料和赛后直接取块。

| 几何参数 | A车 | B车 |
|---|---:|---:|
| 料道条数 | 3 | 3 |
| 单道净宽 | 44 mm起步，实块校准 | 同左 |
| 单道可用长度，沿斜面量 | 144 mm | 144 mm |
| 道间壁厚 | 2 mm | 2 mm |
| 外侧壁厚 | 3 mm | 3 mm |
| 料道部分外宽 | 142 mm | 142 mm |
| 外侧挡墙高度，相对局部仓底 | 约45–50 mm起步，按动态试验调整 | 同左 |
| 初试底板坡度 | 20°，可调至25°试验 | 同左 |
| 144 mm斜道在20°时水平投影/高差 | 约135/49 mm | 同左 |

142 mm仅是料道部分外宽，不含轴承座、外置舵机、进料斗与支架，其计算为3×44＋2×2＋2×3。每道的三块是沿料道排列，不堆成三层。通过薄隔道、低位底部存储和对称入仓控制重心。

总成初步包络：料道部分车长方向约150–155 mm；为避让内收后的60 mm车轮，后端底面离地约65–70 mm，入口端底面约115–120 mm，外侧挡墙最高点约160–170 mm；上方导流斗最高点目标≤190 mm。入口处保留至少60 mm量级的导正过渡空间，再收缩到44 mm料道，防止方块轻微转角后被卡住；该过渡可以沿车长展开，不是要求在190 mm高度内再叠60 mm。该过渡是最需做实物验证的部位，不能把44 mm窄口直接接在自由落体区域。

导流斗转动轴有独立支承，避免由SG90承受掉块冲击。转向时斗内必须为空；满道后禁止继续向该道送块。两个外道交替增加一块，中道用于补齐，避免连续填满单侧三块。计数只在操作手确认实际落块后增加，或另配检测；定时等待不能当作已落块证据。

首版取消上盖、入口活动止退门和专用锁扣卸料门，改为顶部投料与取料。前后端均有固定挡边，方块应完全落在仓底承托和挡边约束范围内。只有实测出现入口倒滑、颠簸跳出或对抗失块时，才针对失效位置增加局部挡片、可拆防跳条或止退结构；不预先把整个料仓封闭。可选挡片避免钩入方块20 mm镂空口，也不得阻碍投料。

20°斜道依赖静摩擦系数μs<tan20°≈0.364；25°时阈值约0.466。用实际方块和实际打印表面测滑动，不假设一定会滚动/滑动。不使用会沾染赛场的润滑剂。若出现卡滞，先修整毛刺、导入口和表面，再调坡度；仍不可靠时才改为低力主动推块机构。

斜道朝车尾下倾时，上坡会更利于向后滑，但下坡可能抵消甚至反转其坡度。因此在平坦处完成分料，坡上禁止投块；行驶途中靠前后端挡边和侧壁约束载荷。设计不能指望26.6°坡上仍靠20°斜道自流。敞口仓仍需在实际坡度、起停和转向条件下验证不会越过挡边；整车倒置保块属于额外目标，不是本版默认要求。

## 5 电源结构

### 5.1 三路供电

每车保留一个2S电池组和一个对外主接口，分流点在主接口之后。多个降压支路不等于多个独立电池供电模块。电池满电8.4 V必须按输入上限检查。

```text
2S 18650电池组（单一主输出，带匹配保护）
  正极 → 近电池保险 → 主开关 → 官方无线断电组件 → 分电点
                                                    ├ 电机降压 5.0 V → 两块DRV8833的VM → 四个TT电机
                                                    ├ 舵机降压 4.8 V → MG995、夹爪SG90、分料SG90
                                                    └ 原Mini降压 5.0 V → STM32板的5V输入、PS2转接板输入
  负极 → 星形公共地 ──────────────────────────────── 各路降压GND、驱动GND、舵机GND、控制GND

STM32板上稳压器：5 V → 3.3 V → MCU与GPIO
PS2转接板：5 V输入 → 板载3.3 V稳压 → 接收器（以实物板型一致为前提）
```

无线继电器型号尚未确定，必须按其VCC/GND和COM/NO或IN/OUT定义接线，不能套用未知端子排列。若是干接点模块，接收器从主开关后、触点前取电，电池正极进入COM，NO接分电点，负极共地。接收器电压必须匹配2S；不匹配时按官方模块方案供电。触点的直流额定电流和启动浪涌能力须覆盖全车，不能仅看交流额定值。实际模块若只能可靠切底盘，就让其切电机支路，并另行处理比赛结束的整机断电；机械保块设计不变。

三个输出正极不能相连。两块普通降压器不允许简单把输出并在一起“翻倍电流”；分负载供电才是本方案做法。舵机动力电流不经过STM32板、电机驱动板的细排针供电走线或面包板。

### 5.2 电流预算

下表是选型初算，非这批器件的实测参数。启动和堵转电流需要用限流电源、采样电阻/示波器或具备峰值记录的仪表测量，不能仅看普通万用表慢速读数。

| 支路 | 暂定工作电流 | 暂定短时峰值 | 模块最低设计目标 |
|---|---:|---:|---|
| 4个TT电机，5.0 V | 每个0.3–0.6 A，总1.2–2.4 A | 每个1–1.5 A，总4–6 A | 有散热条件下真实连续≥5–6 A，启动短时能力≥8 A；最终服从测量结果 |
| MG995＋2个SG90，4.8 V | 约1–2 A量级，动作相关 | 初算2.5＋0.8＋0.8=4.1 A | 真实连续≥5 A；峰值≥6 A；动态压降合格 |
| STM32＋PS2，5.0 V | 预留0.15–0.30 A | 随接收器批次测量 | 原Mini模块先按≥0.5 A稳定输出验收 |

原小降压板的“3 A”仅为器材文档中的同类产品标称，无法证明本板持续能力。上述两个动力支路的峰值合计已约10 A，明显不能交给它。换成常见标5 A的大板也不等于能持续5 A，必须看具体板的输入范围、输出余量、散热与温升曲线。

MG995与SG90统一4.8 V供电，是为了兼容SG90官方4.8 V规格并减少电源支路。不得把全部舵机一起接6 V。若后续MG995在4.8 V确实不够力，先减轻夹爪/缩短力臂；仍需要6 V时，仅对MG995增加独立合格支路，不能把SG90跟着升压。

峰值功率示例：5×6＋4.8×4.1＋5×0.3≈51.2 W。若电池加载后为6.4 V、综合效率按85%，电池电流约51.2/(6.4×0.85)=9.4 A。故电芯、保护板、主线、插头及继电器应按约10 A级瞬态链路审查，并留余量；电芯优先有真实持续放电规格的≥10 A型号。串联两节每节都承受相同电流，不能把两节放电能力相加。

电池盒弹簧、细引线可能比电芯更先限流或发热。若不能通过负载测试，换为可靠焊片/点焊电池组或适用的高电流固定方式。保护装置应同时覆盖过充、过放、过流，采用一致的电芯；可拆卸电芯用匹配的单节充电器，固定2S电池组用匹配的2S充电方案。保护板不能弥补劣质电芯或细线。

普通降压器需有压差：按约6.4–8.4 V输入验证5 V/4.8 V输出，不只在满电8.4 V下测试。低电压时应减速并停止高负载动作，截止点依据所选电芯、每节状态及保护板确定；不要只根据两节总电压假定单节都健康。

### 5.3 驱动电流是第二道限制

DRV8833不是降压器。TI规定VM工作范围2.7–10.8 V，但TT电机常见3–6 V，因此不能因为DRV8833能接8.4 V，就让TT直接承受满电电池电压。限占空比也不等同于提供有硬电压边界的5 V电源，本方案采用电机专用降压。

TI给出的每桥1.5 A RMS、2 A峰值仅适用于PWP/RTY封装，PW封装只有0.5 A RMS；小红板的散热还可能进一步降低能力。每桥只带一个电机；先识别芯片封装及板布局，不能按板颜色判断。若单电机启动或负载需求超出该模块能力，应换真实更高电流且支持3.3 V输入的驱动模块，或降低整车负载；电源加大不会修复驱动瓶颈。

若板上引出且正确配置ISEN，芯片可通过采样电阻限流，典型关系Itrip≈0.2/Rsense；很多便宜模块把ISEN直接接地，此时没有可由程序设置的精确电流环。nFAULT只是故障标志，不是电流测量值。不要把芯片短路保护当连续堵转限流器。

### 5.4 接线与抗干扰

- 主电源线约18–20 AWG短线，动力支路约20–22 AWG，按实际电流、长度与温升调整；动力不用杜邦线。主保险初选约10 A并依据启动曲线和最弱导线/触点额定值定案，不能照抄定值。
- 动力负极直接回星形分电地，控制地单独回星点。共地不等于把电机大电流串过控制板地线。
- 驱动VM旁预留470–1000 µF低ESR电容；舵机分电点预留1000–2200 µF；额定电压留余量并确认模块允许该输出电容。电机端子并100 nF瓷片电容，短引线；板级去耦保留。
- 电容不能补持续电流缺口：2200 µF、3 A、1 ms脉冲理想压降已经约1.36 V。因此先保证电源能力和线阻，再调电容。
- 快速反转可能引起回灌过压，降压板不一定能吸收能量。程序先减速至零再反转，并实测电机母线过冲；若仍超限，使用匹配的吸收/钳位方案，不盲装未知电压TVS。
- 翻转臂线束留活动弯曲余量和固定点，不能跨过齿轮啮合区，也不能靠插头承受线束拉力。

## 6 STM32和信号分配

STM32F103芯片工作电源为2.0–3.6 V，本方案使用3.3 V。核心板“可以输入5 V”是因为板上稳压器将其变为3.3 V；5 V只能接确认存在的5V/USB电源入口，不能接3V3脚、VDD或普通信号脚。若不是所述带稳压核心板，应另配稳定3.3 V电源。

PS2器材图显示转接板带3.3 V稳压和反接保护，建议从独立逻辑5 V支路给转接板供电，不把大电流舵机接在该板上。确认实物板一致，再测DAT高电平。3.3 V GPIO直接控制DRV8833输入满足其门限；舵机3.3 V PWM是否被本批次稳定识别须测试，不识别时增加适合单向推挽信号的电平缓冲。不能因为板子“5 V兼容”就假定所有信号都可上5 V。

推荐每车相同引脚表，采用两个输入均具PWM能力的驱动方式：

| STM32引脚 | 功能 | 对端 |
|---|---|---|
| PA0 / PA1 | TIM2 CH1 / CH2，左前电机双输入 | 前驱动板AIN1 / AIN2 |
| PA2 / PA3 | TIM2 CH3 / CH4，右前电机双输入 | 前驱动板BIN1 / BIN2 |
| PA6 / PA7 | TIM3 CH1 / CH2，左后电机双输入 | 后驱动板AIN1 / AIN2 |
| PB0 / PB1 | TIM3 CH3 / CH4，右后电机双输入 | 后驱动板BIN1 / BIN2 |
| PB6 | TIM4 CH1，约50 Hz舵机PWM | MG995信号 |
| PB7 | TIM4 CH2，约50 Hz舵机PWM | 夹爪SG90信号 |
| PB8 | TIM4 CH3，约50 Hz舵机PWM | 分料SG90信号 |
| PB12 | GPIO输出 | PS2 ATT/SEL |
| PB13 | GPIO/兼容SPI时序 | PS2 CLK |
| PB14 | GPIO输入 | PS2 DAT，注意是接收器发给STM32 |
| PB15 | GPIO输出 | PS2 CMD，STM32发给接收器 |
| PA8 | 输出，复位时保持驱动休眠 | 两驱动板nSLEEP，只有确认板上无冲突固定上拉时才连接 |
| PB10 / PB11 | 输入，可选各加上拉至3.3 V | 两板nFAULT，若引出；勿接5 V上拉 |
| PA4 | ADC，可选 | 电池检测，经分压和滤波，绝不直连电池 |
| PA13 / PA14 | SWD保留 | SWDIO / SWCLK |
| PA9 / PA10 | 调试口预留 | 串口TX / RX |

PA0–3与PA6/7/PB0/1的电机PWM可从约15–20 kHz起调；TIM4单独设约50 Hz，避免和电机共用频率。PS2为SPI-like，按接收器实际位序与时序驱动，不能仅配置标准SPI默认模式就假定成功。

DRV8833输入：00滑行，10一个方向，01反向，11制动；轮子的实际正转方向按安装实测统一。nSLEEP若已硬拉高，不可用GPIO直接硬拉低与板上线路对抗。上电时全部电机输入置低，接收器连接和中位检查通过后才允许使能。

示例电池ADC分压可用上臂22 kΩ、下臂10 kΩ，8.4 V对应2.625 V；并适当滤波并设足够ADC采样时间。该检测节点放在受主电源管理的线路上，避免主板断电时经ADC反向供电。

调试时只选一个板级供电来源，避免USB 5 V、外部5 V和ST-Link电源相互回灌。外部供电时ST-Link主要接GND/SWDIO/SWCLK，目标电压参考脚按仿真器的实际定义处理，不能把未知仿真器3.3 V输出当只读参考直接并入。

## 7 重心和稳定性

满载也以单层存储为主，不设计高而窄的随机堆料篮。每车称量各模块，用zCG=Σ(mizi)/Σmi核算；所有状态都要考虑，包括单侧满载、抓住方块且臂水平前伸、刹车和转向。

举例：空车1.15 kg、重心55 mm，9块各30 g、平均高度115 mm，则装块后重心约66.4 mm。若0.12 kg臂端组件再升高130 mm，整体重心增加约11 mm，升至约77.4 mm。这组数字说明趋势，不是已测量值。为了内收轮子而抬高上部料仓增加了重心，须在样机中复核，而不是继续沿用宽轮距时的稳定性结论。

以约77 mm重心高度和轮中心近似支撑边界，两车半支撑宽约52.5–55 mm，静态侧翻角约34–36°。真实滚子接触、装配弹性和外推力会降低余量，不能据此允许高速侧坡行驶。26.6°侧坡会让重力投影横移约38.5 mm，两车余量都已较小；故坡上沿坡向走，禁横移和急转。185 mm车壳本身不等于185 mm的轮支撑宽度。

一般检查条件：重心到最近支撑边的距离d，应大于hCG×tan坡角＋hCG×横向加速度/g＋装配与接触误差余量。地面推力高度也应尽量低，近似水平推力侧翻阈值为Ftip≈Mg d/hpush；低位推面有利，但需同时检查纵向前翻。

坡道还受牵引与托底限制。坡比0.5在忽略其他损失时就需要有效附着系数至少0.5。示例满车1.5 kg、轮半径30 mm、滚阻系数0.03、等效传动/麦轮效率0.7时，每轮爬26.6°坡约需0.076 N·m即0.78 kgf·cm。这里效率是假设，应与TT实测工作扭矩比较，不能拿堵转扭矩验收连续爬坡。

轴距165 mm、中央离地25 mm的理想对称越顶角约2atan(2×25/165)=33.7°；实际还要考虑电池盒、螺钉和舵机的最低点。低位推面在平地可接近地面，但上坡前必须收起到不刮坡面的高度。

## 8 战术与容量

规则共有18白＋5黄，尺寸相同；普通遥控白1分、黄4分，共38分。注意总分是38，不是按23个道具的数量平分胜负。3黄＋8白=20分，在双方都按普通遥控倍率计分时，超过全场38分的一半；若对方经认定有自动/半自动加成，不能再用20分作为必胜阈值。执行一键翻臂并不会自动取得半自动资格。

两车相同，每车9块，共18个仓位；容量是上限，不是要求每局装满。A车的任务预算是中央1黄＋周边4白，再留1个常用机动位，因此通常5–6块即可；B车按洞穴和挂架黄色核心优先，常用6–9块。多余相同仓位让两车能互相补位，代价是A车空仓略重。它们是任务预算，不保证这些资源没有被对方抢先获取。若重量或空间测试不合格，统一将两车改为2道×3块的6块仓，而不是强留9块高仓。

红方示例：A从h5沿f5/g5桥向中央，桥上白块位置及是否能从桥面抓取需现场核对；B从a1绕地面优先处理d1洞穴和近侧资源，再考虑e3挂架及远侧。蓝方镜像处理。中央白块和焦点由A优先，避免两车争同一个入口。

挂架须沿杆滑脱，洞穴只让窄爪伸入。夹不到的高分块应及时放弃，按操作手训练记录决定每块尝试时限。直上150 mm台阶不计入可行路线。B车虽然具备相同过桥能力，仍以地面任务为主，只在桥面腾空时补位。

常态两车各自携带，不把反复交接作为主流程。规则按结束时车上道具算分，没有“把方块卸到己方地面就得分”的机制。A满仓后选安全平坦处保分或沿已验证路线下坡；B继续补收。末段收臂、停止高风险争抢；同时注意全队持续1分钟无动作也可能触发结束条件，不能把比赛必然持续满5分钟作为策略前提。

## 9 材料增补与成本

优先保留：两块STM32、两套PS2、八个TT、四块DRV8833（通过实测后）、两个MG995、四个SG90、两块Mini逻辑降压、现有轮子。新增优先级：电池与可靠供电链路→四块动力降压器→两车结构件与敞口分道料仓→线束固定与去耦。暂不增加双MG995同步驱动、摄像头、输送带和大型主动推翻机构。

| 全队增补 | 数量 | 核心要求 |
|---|---:|---|
| 电机用降压 | 2 | 2S输入末端仍稳定5 V，真实5–6 A连续及足够启动能力 |
| 舵机用降压 | 2 | 2S输入，4.8 V可调并锁定，真实5 A连续、≥6 A短时 |
| 18650 | 4 | 同型同批次，可信≥10 A放电规格；容量优先于虚标毫安时 |
| 保护、保险、开关和主插头 | 各2套 | 匹配电流，电池组单输出；继电器按官方指定另列 |
| 自制底盘、臂根、双臂、夹爪、导流斗、仓底及挡边 | 2套 | 螺接、可维修；优先PETG等适合受力件的材料，打印参数需试样验证 |
| 转轴、轴套/轴承、锁紧件 | 2套 | 主轴独立支承；首版不购入口止退门及其回位件 |
| 导线、去耦电容、绝缘片、绑带 | 2套 | 不让动力经过面包板、杜邦线和控制板供电走线 |

规则附录整套参考金额325.88元，距420元仅余94.12元，而电池原本未计价，因此不能把所有新增器材都简单加到原套件后。当前采购计划需替换而不是照单全买；若两车改用自制骨架，不再重复计购对应金属底盘。若保留原板，则需把它和改装件一起计入费用，重新核算，不能套用下面的扣除示例。

下面仅是满足上限的采购控制示例，不是市场报价或已锁定供应商：原套件扣去两块金属底盘22.40元、面包板4元后为299.48元；四节合规电池目标≤32元，四块动力降压目标≤38元，打印原料与必要机械件目标≤30元，额外电气材料目标≤15元，合计414.48元，余量只有5.52元。上述价格目标可能买不到满足要求的产品；若真实报价超限，应重做清单、利用已有可复用件并与组委会确认计价口径，不能以降低电源安全性来凑数。若全部旧器材已采购，能否扣除不上车件需要依据正式计价口径判断，不能自行默认退款或费用豁免。

## 10 验收与尚未冻结的参数

1. 尺寸与称重：安装全部车轮、螺钉、插头和线束后测外廓；空仓、满仓和全臂扫掠均核对。两车轮外宽135–140 mm目标优先实测，并确认轮槽、电机、料仓底板互不干涉。
2. 单件电流：限流电源下记录每个TT空载、典型负载和极短受控堵转电流；舵机测试用负载臂，不长时间硬顶机械止挡。
3. 分路电源：在接近2S低端和满电输入分别加载，测最远端电压、启动跌落、反向回灌和温升；不能只在空载测到5 V就合格。
4. 联动测试：四轮启动/反向与翻臂同时发生时，STM32无复位、PS2不掉线、舵机不乱跳、驱动不反复热保护。若实际峰值高于预算，回到驱动与电源选型。
5. 电源故障状态：上电中位检查，PS2连续丢失约300 ms时停止轮驱动并禁止新动作，不能让通信恢复后自动续跑；该时间是初试值。正常姿态断电后，方块仍应由仓底与挡边可靠承托。
6. 料仓台架：每道连续测试至少50次实际40 mm块，覆盖偏角、边角、入口边界；记录失败，不宣称计算即证明“不卡”。满道拒收可见，方块实际落到仓内可确认。
7. 携带：正常姿态断电后平移机器人、抬起和缓慢降低，确认方块随车运动；方块留在地面不符合该目标。另用实际坡度、起停和转向测试行驶可靠性。完整翻转后不掉块不是所提供规则的明确要求，不作首版验收条件。
8. 行驶：低位样桥上空载/满载各20次；26.6°样坡测试上坡、下坡、坡顶托底；抬臂状态不作为通过坡桥的默认姿态。
9. 结构：先检查电池和打印件，再按规则要求做180 mm底面朝下跌落展示；实际不合格应改结构，不能用易脱落件掩盖。
10. 对局：两车完成5分钟带负载演练，核验遥控断电和恢复、资源分工及装块确认，不依赖第三名队员现场指挥。

待实测后才能冻结：底板和车轮实际包络、TT堵转与爬坡工作电流、DRV8833封装与散热、MG995实际行程和可持续扭矩、方块重量与斜道摩擦、PS2转接板真实供电/电平、官方无线继电器端子与电流额定值、供应商含税运费后的成本。这里没有伪造这些缺失参数。

## 参考来源

- 本地《CRTC2026规则文档v1.0.pdf》：第5–8页技术规范与考核；第13–18页场地、道具、计分与行为；第20–21页物资和组别限制。
- 本地《器材参数.docx》：现有器件数量、包络及卖家图片。文字及内嵌图片已读取；当前环境缺少LibreOffice，未获得整份Word的页面渲染，因此不引用未验证页码。
- ST STM32F103C8产品信息：https://www.st.com/en/microcontrollers-microprocessors/stm32f103c8
- ST STM32F103x8/xB数据手册：https://www.st.com/resource/en/datasheet/stm32f103c8.pdf
- TI DRV8833数据手册：https://www.ti.com/lit/ds/symlink/drv8833.pdf
- TowerPro SG90 Analog规格：https://towerpro.com.tw/product/sg90-analog/

MG995数值沿用器材文档参考，不借用网页标题为MG996R/360度产品的数据来冒充这批180度MG995的独立验证。
