Seroliya/zqcs-team-robotics/tmp/.codex-remote-attachments/01a0a01a-cbd2-7dc2-ab4b-b73ab8f8ab72/33ff4dc5-6c93-486b-8bf0-823b95b06514/1-Photo-1.jpg

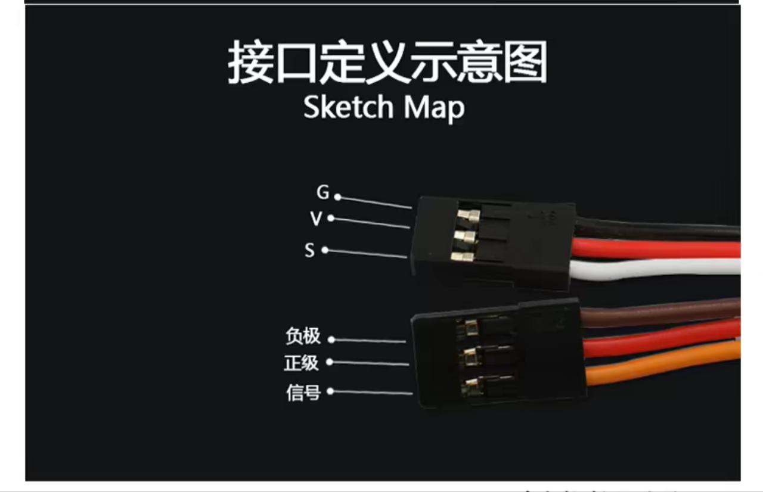
tmp/.codex-remote-attachments/01a0a01a-cbd2-7dc2-ab4b-b73ab8f8ab72/33ff4dc5-6c93-486b-8bf0-823b95b06514/1-Photo-1.jpg
