Seroliya/zqcs-team-robotics/tmp/pdfs/block-study/rack-detail-14.png

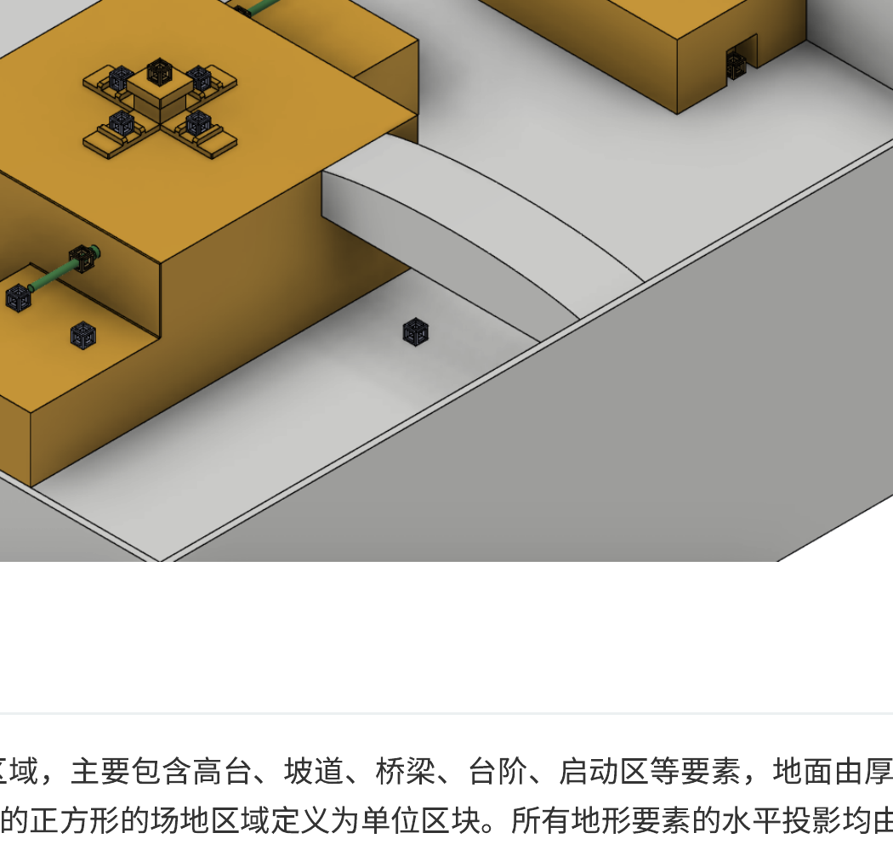
tmp/pdfs/block-study/rack-detail-14.png
