Seroliya/zqcs-team-robotics/tmp/pdfs/block-study/rules-13.png

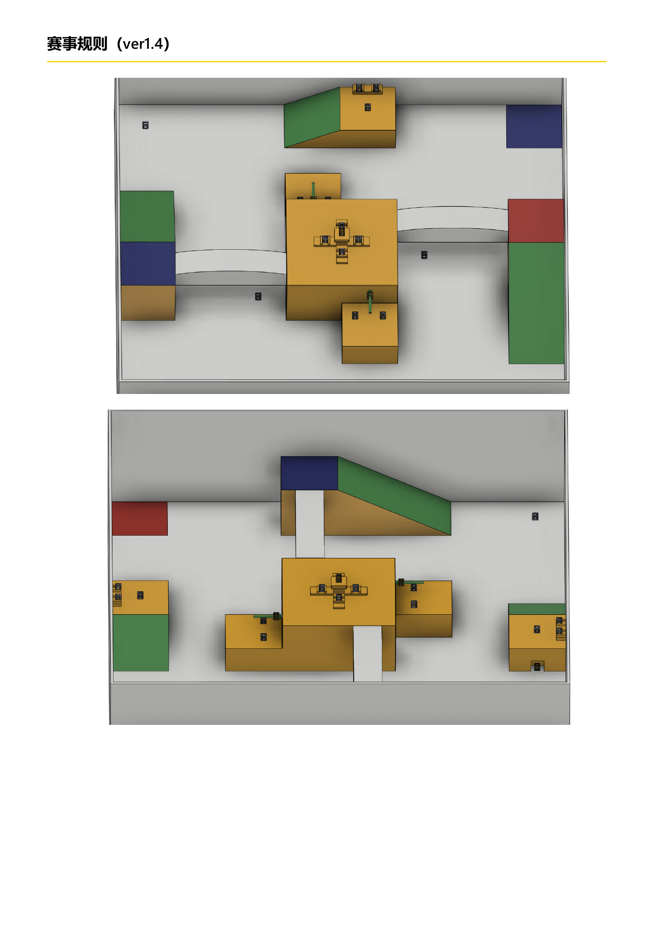
tmp/pdfs/block-study/rules-13.png
