Seroliya/zqcs-team-robotics/tmp/pdfs/block-study/rules-14.png

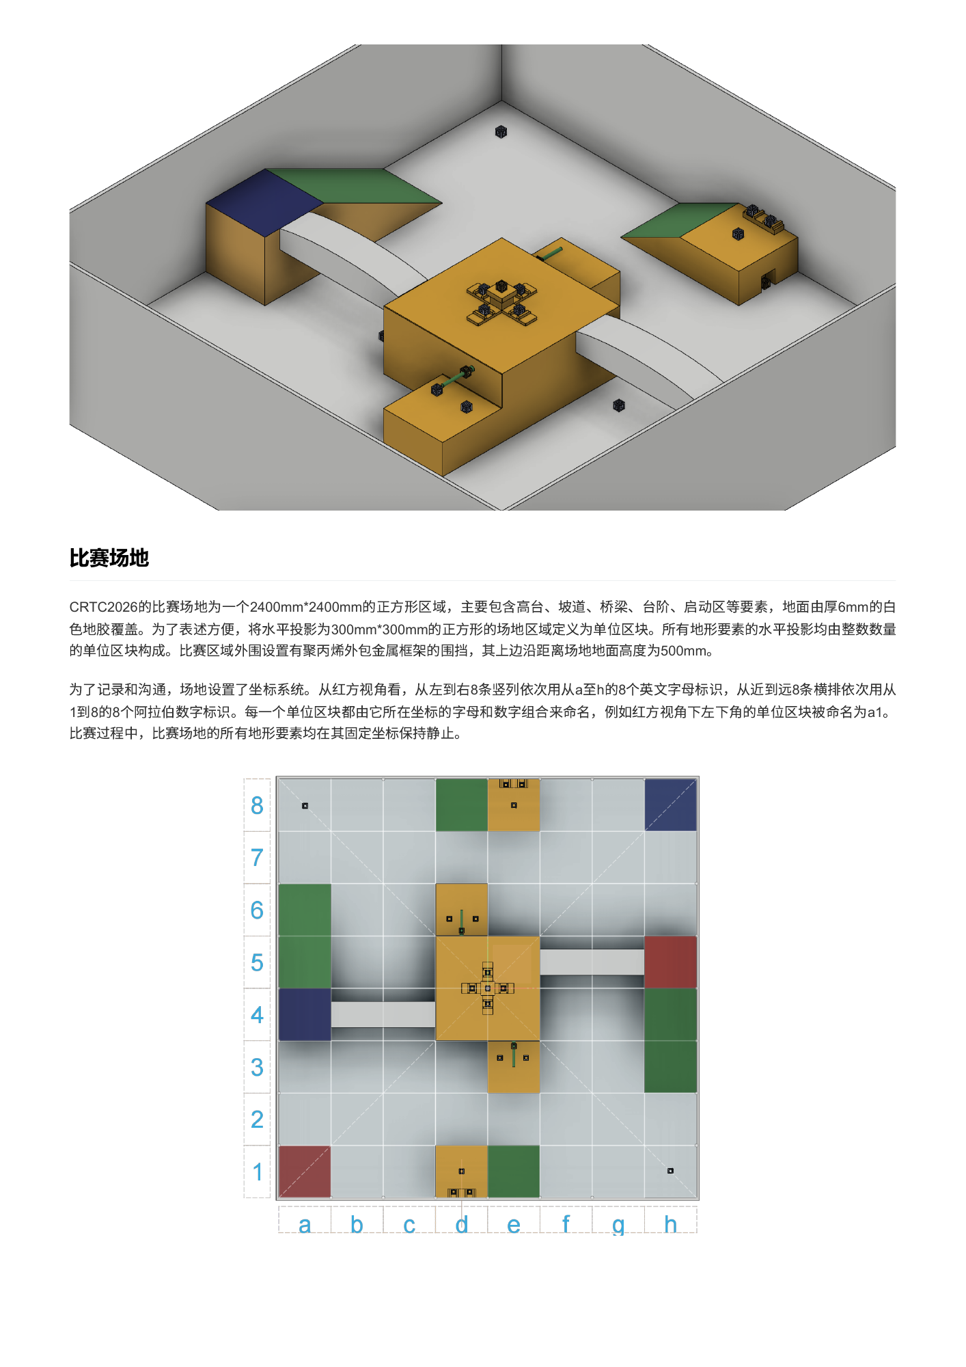
tmp/pdfs/block-study/rules-14.png
