Seroliya/zqcs-team-robotics/tmp/pdfs/block-study/rules-15.png

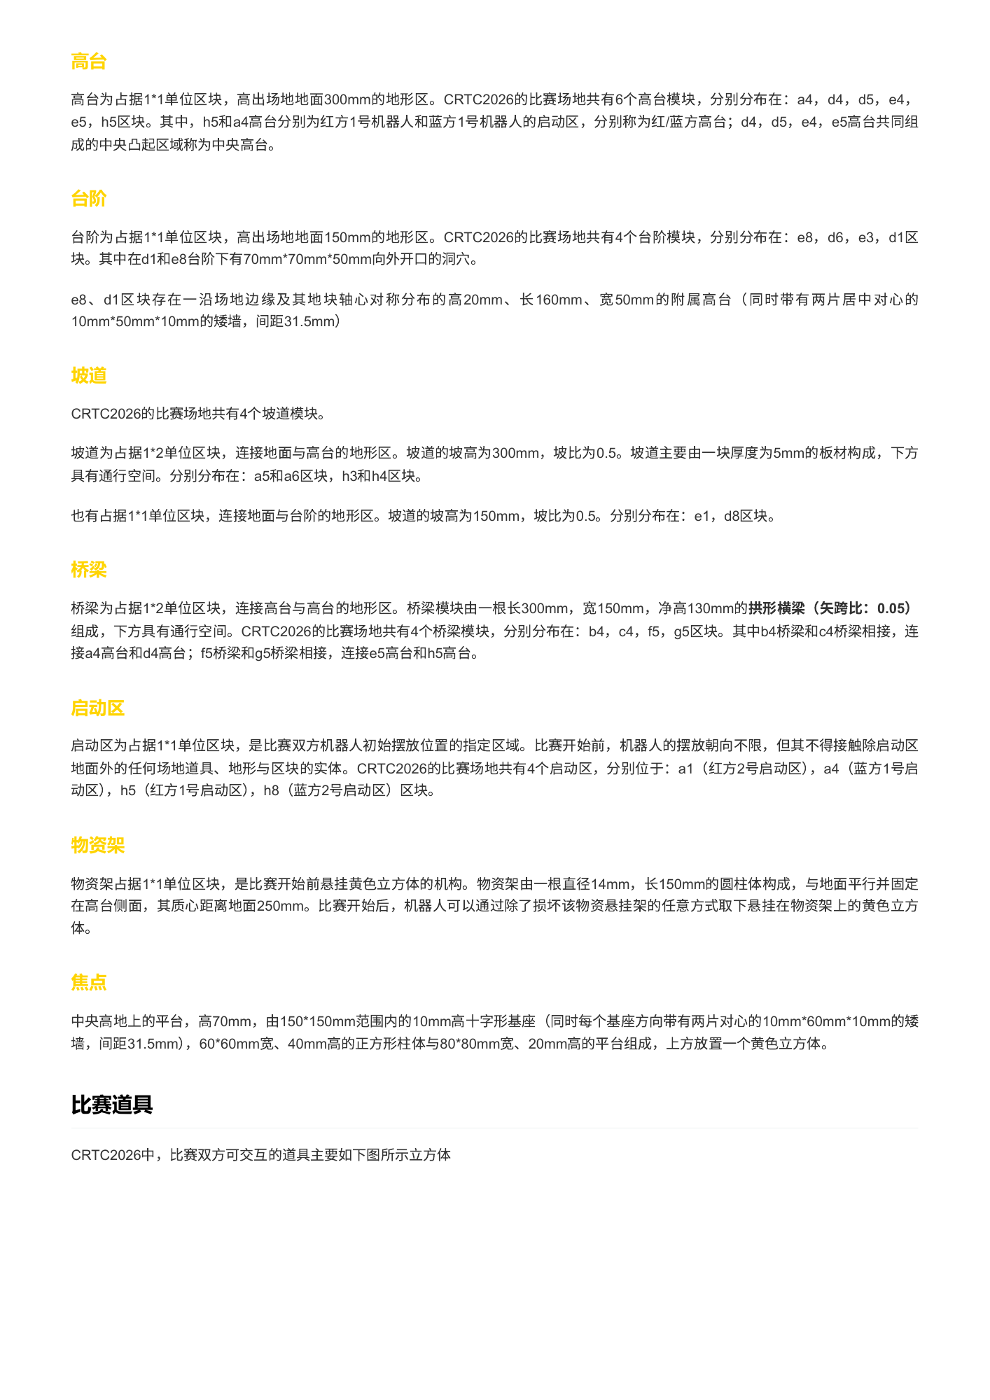
tmp/pdfs/block-study/rules-15.png
