Seroliya/zqcs-team-robotics/tmp/pdfs/block-study/rules-16.png

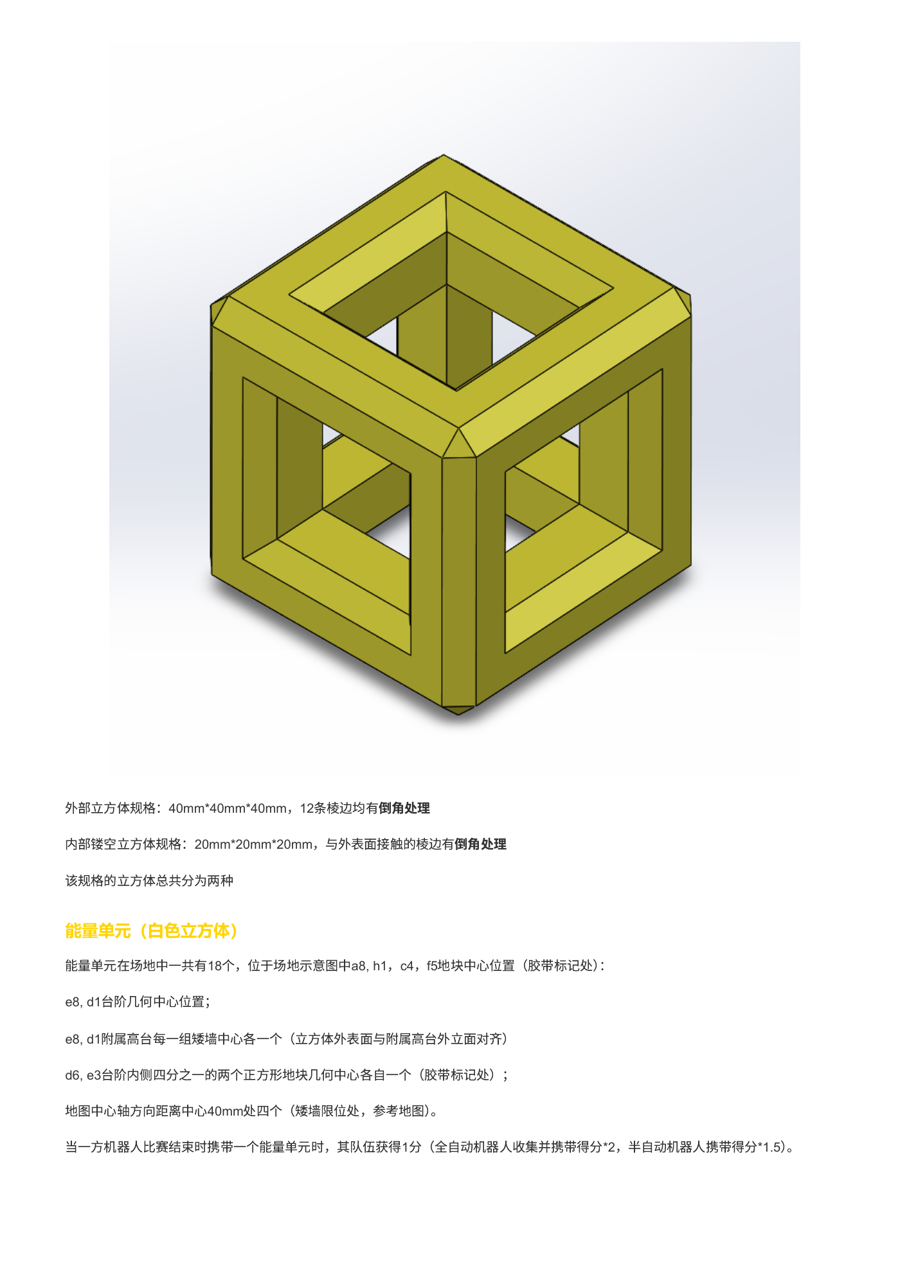
tmp/pdfs/block-study/rules-16.png
