Seroliya/zqcs-team-robotics/tmp/pdfs/block-study/rules-17.png

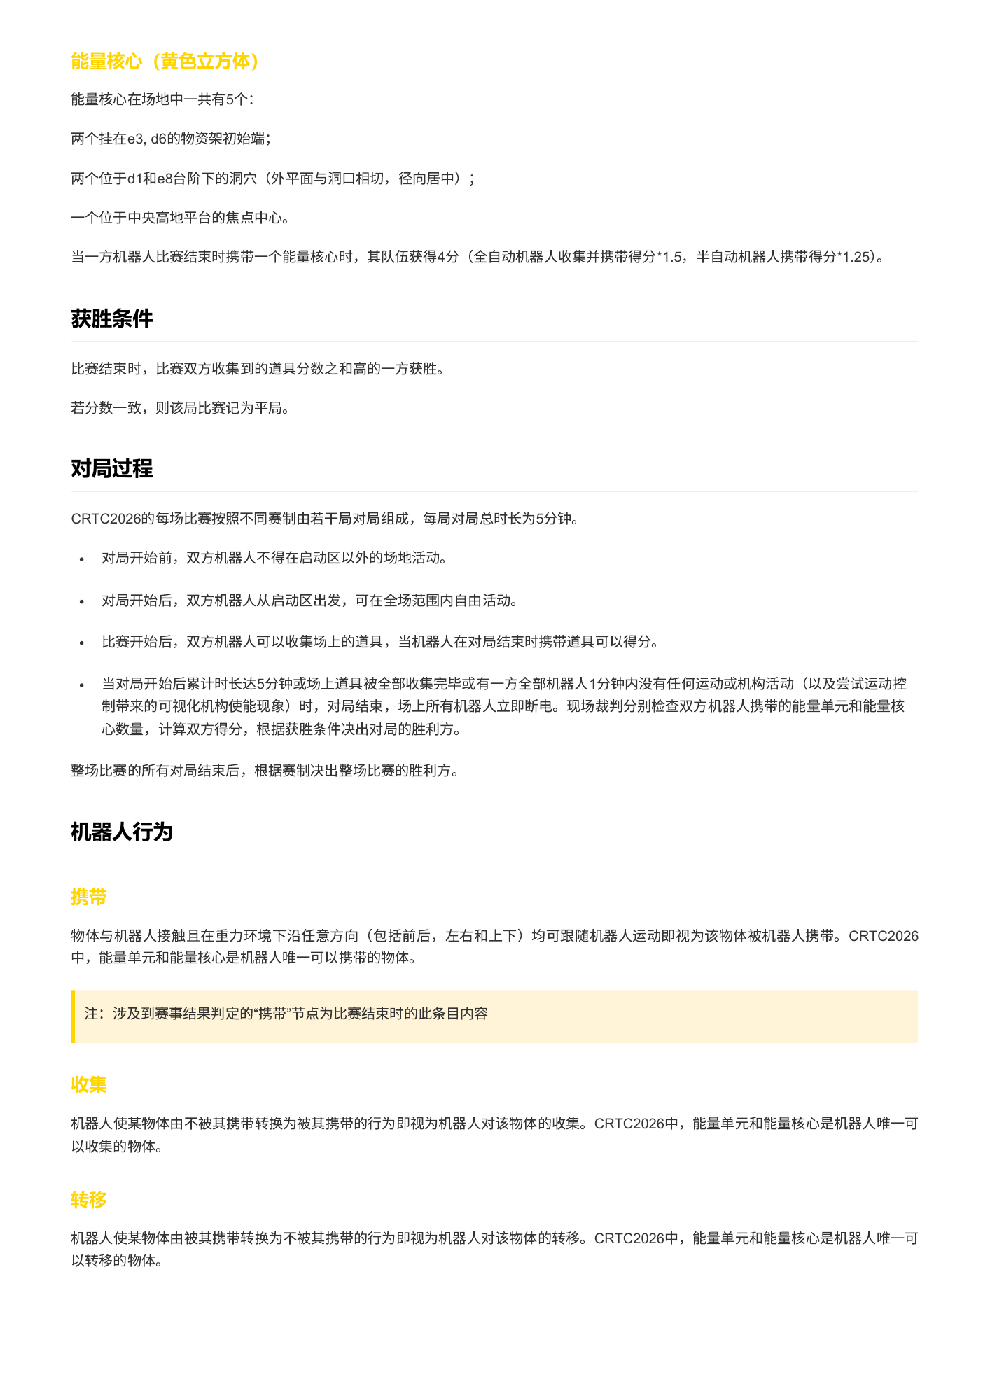
tmp/pdfs/block-study/rules-17.png
