Seroliya/zqcs-team-robotics/tmp/sources/preview-320.png

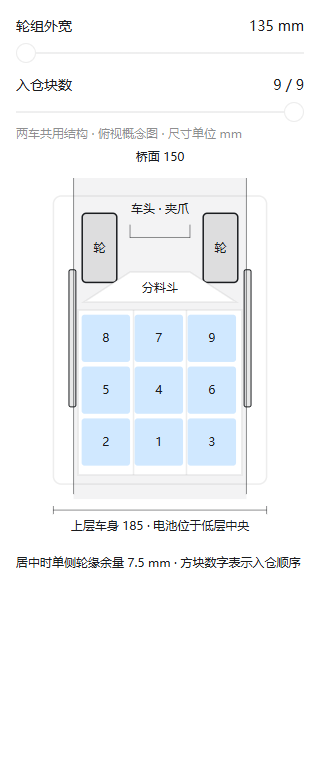
tmp/sources/preview-320.png
