Seroliya/zqcs-team-robotics/tmp/sources/preview-736.png

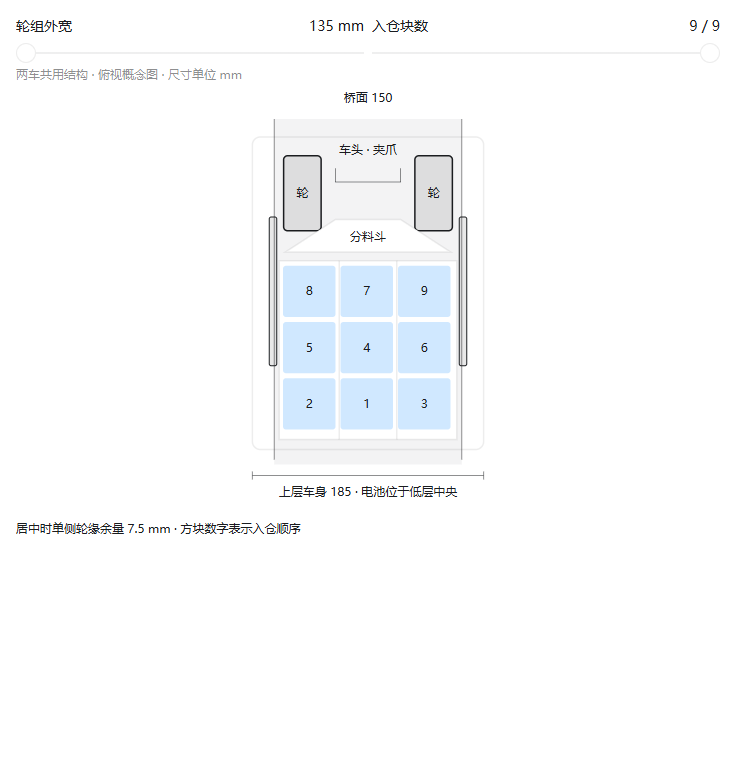
tmp/sources/preview-736.png
