Seroliya/zqcs-team-robotics/tmp/sources/robot-3d-dark.png

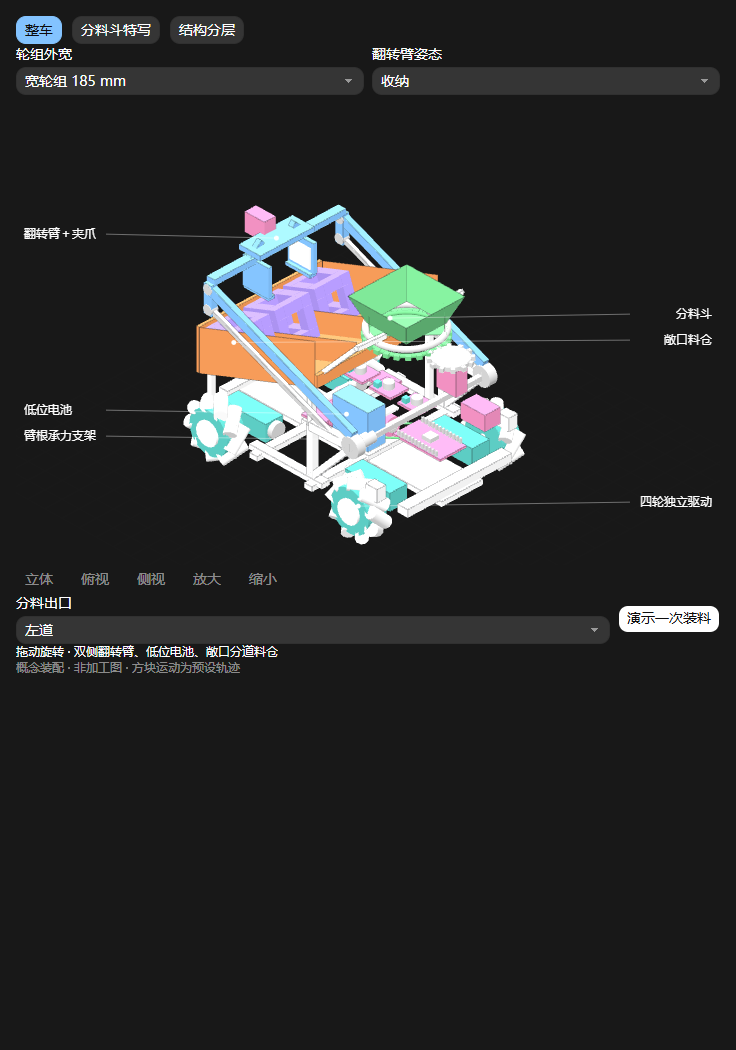
tmp/sources/robot-3d-dark.png
