Seroliya/zqcs-team-robotics/tmp/sources/robot-3d-explode.png

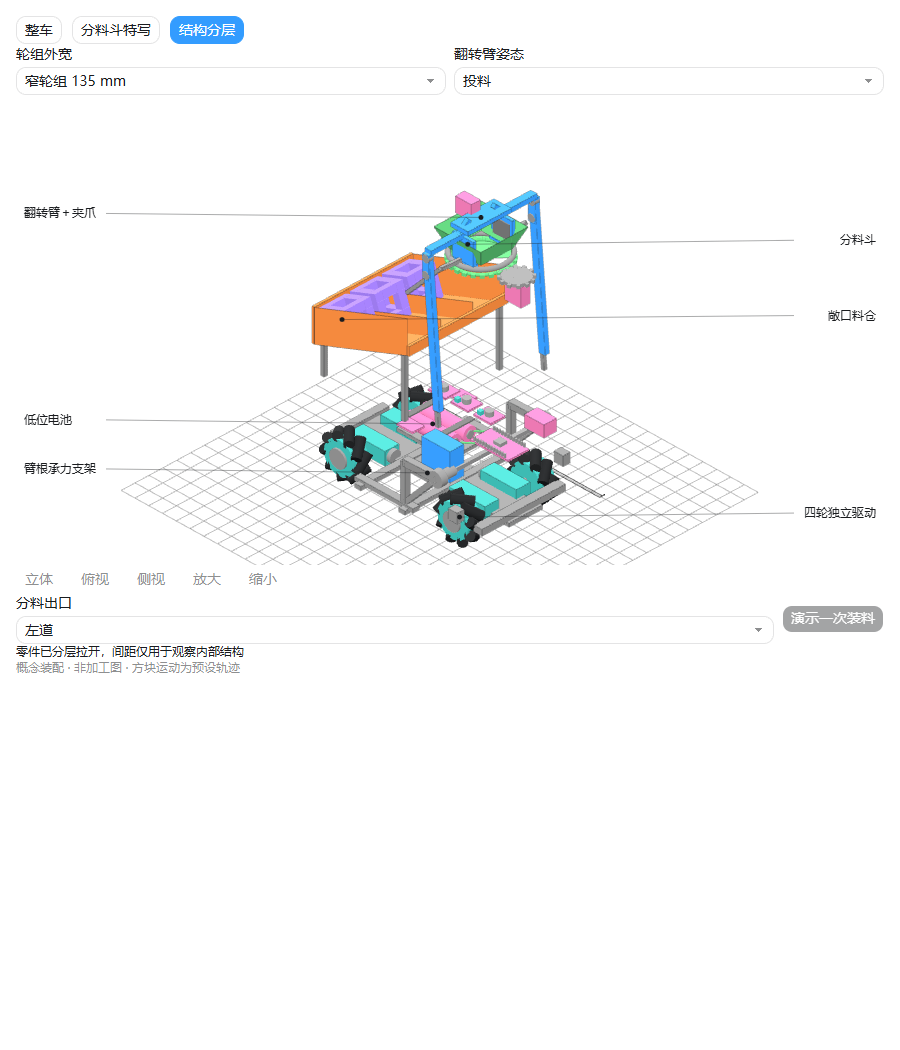
tmp/sources/robot-3d-explode.png
