Seroliya/zqcs-team-robotics/tmp/sources/robot-3d-feeder.png

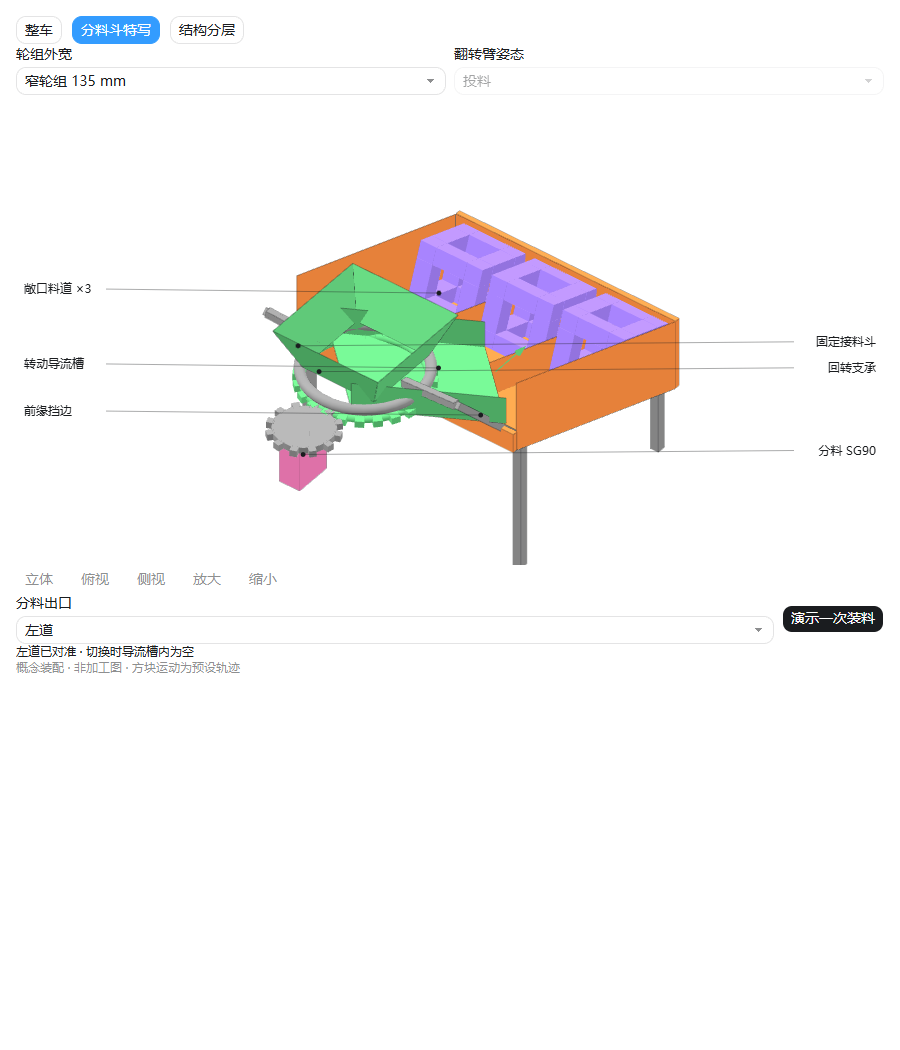
tmp/sources/robot-3d-feeder.png
