Seroliya/zqcs-team-robotics/tmp/sources/robot-3d-mobile.png

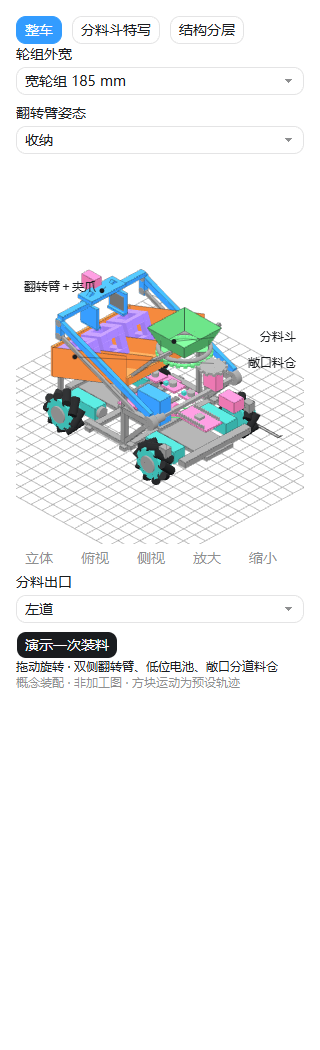
tmp/sources/robot-3d-mobile.png
