Seroliya/zqcs-team-robotics/tmp/sources/robot-3d-stow.png

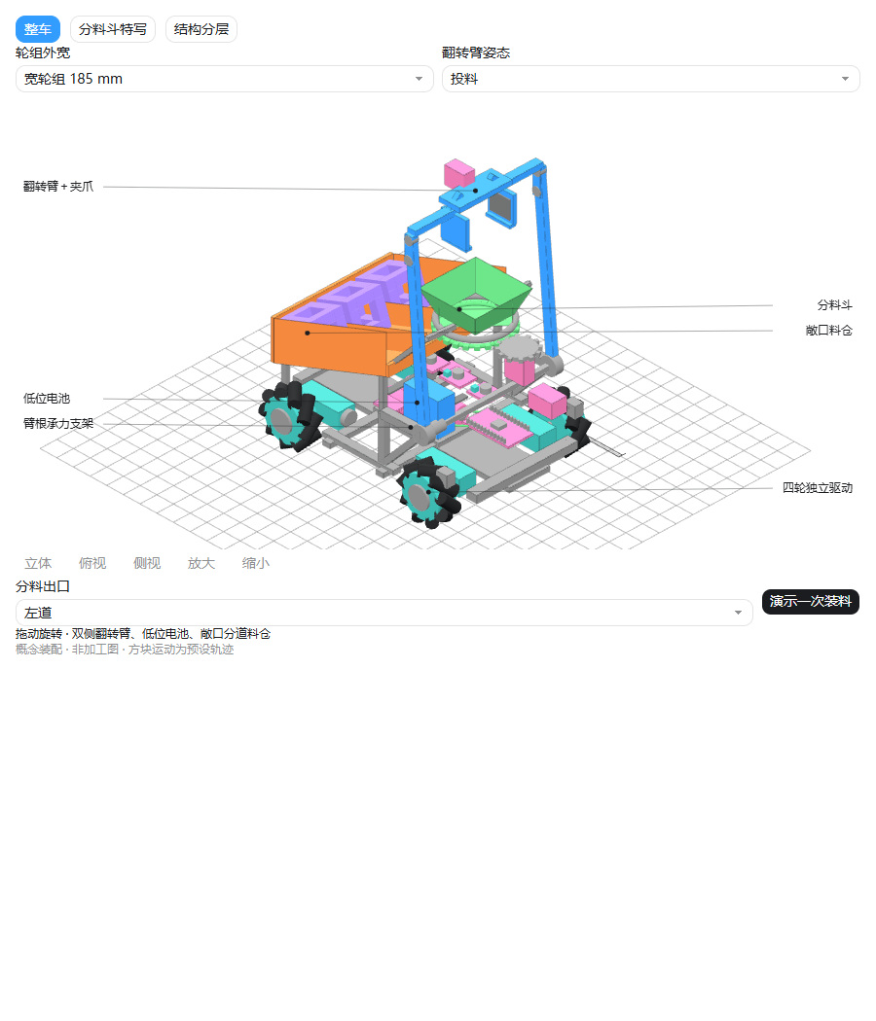
tmp/sources/robot-3d-stow.png
