Seroliya/zqcs-team-robotics/tmp/sources/rule-05.png

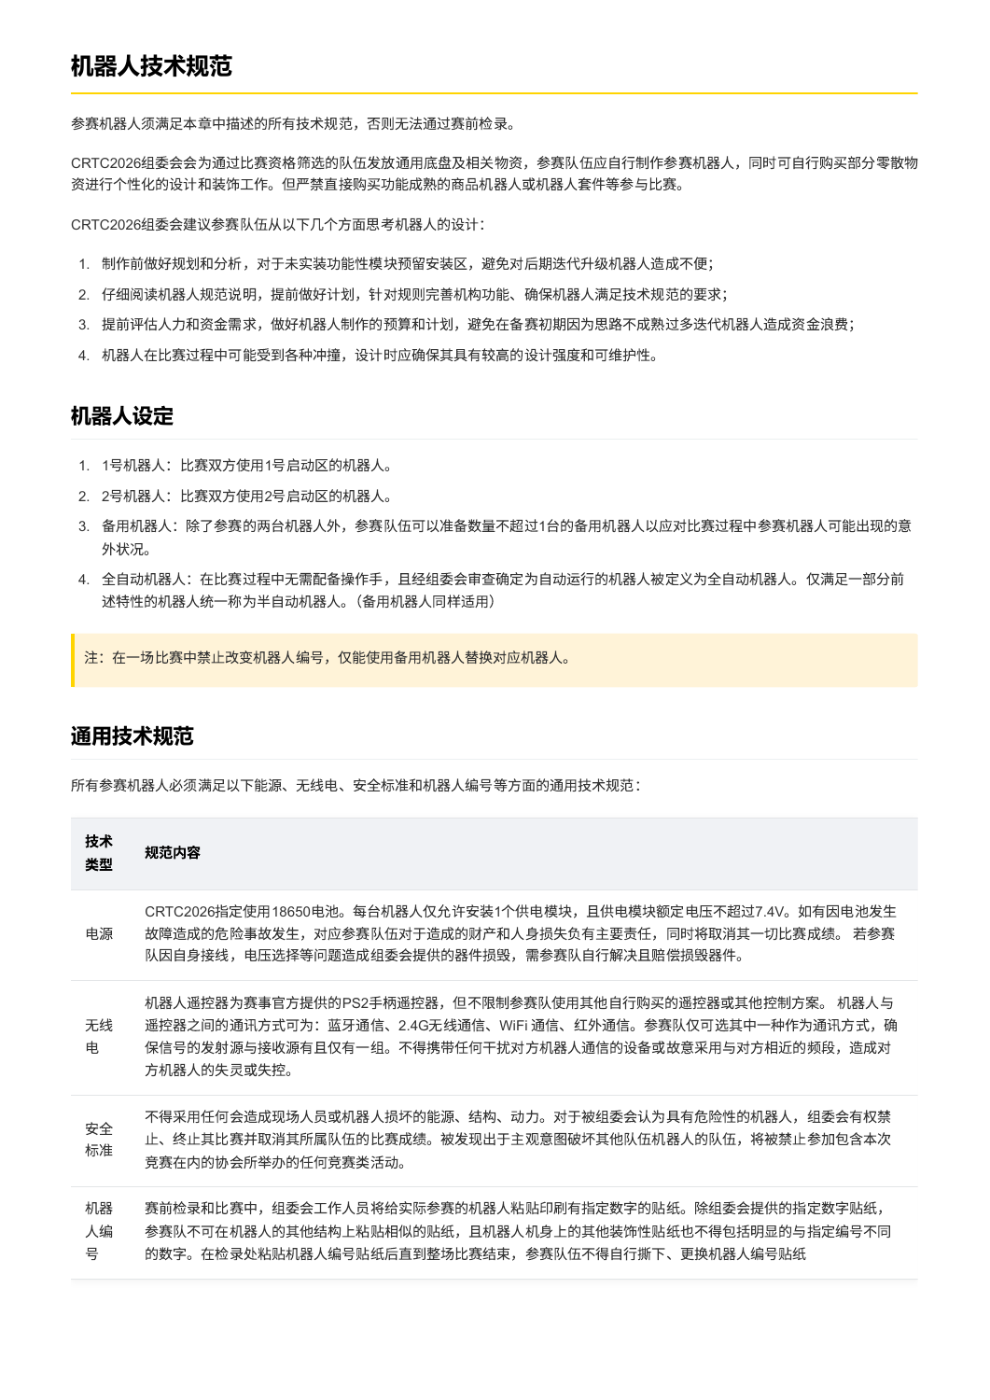
tmp/sources/rule-05.png
