Seroliya/zqcs-team-robotics/tmp/sources/rule-06.png

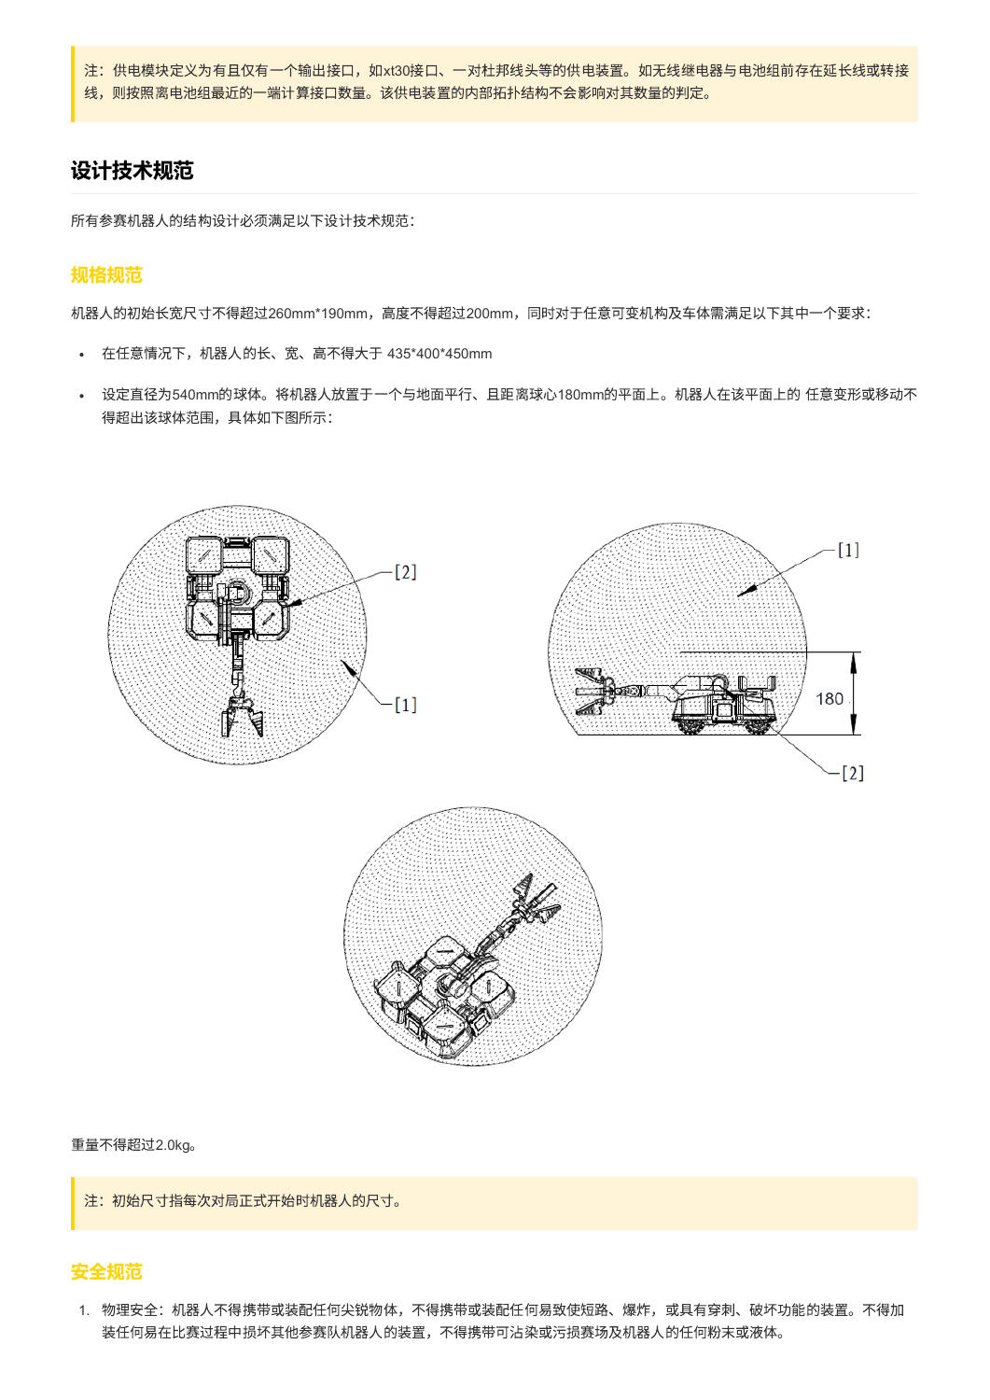
tmp/sources/rule-06.png
