Seroliya/zqcs-team-robotics/tmp/sources/rule-07.png

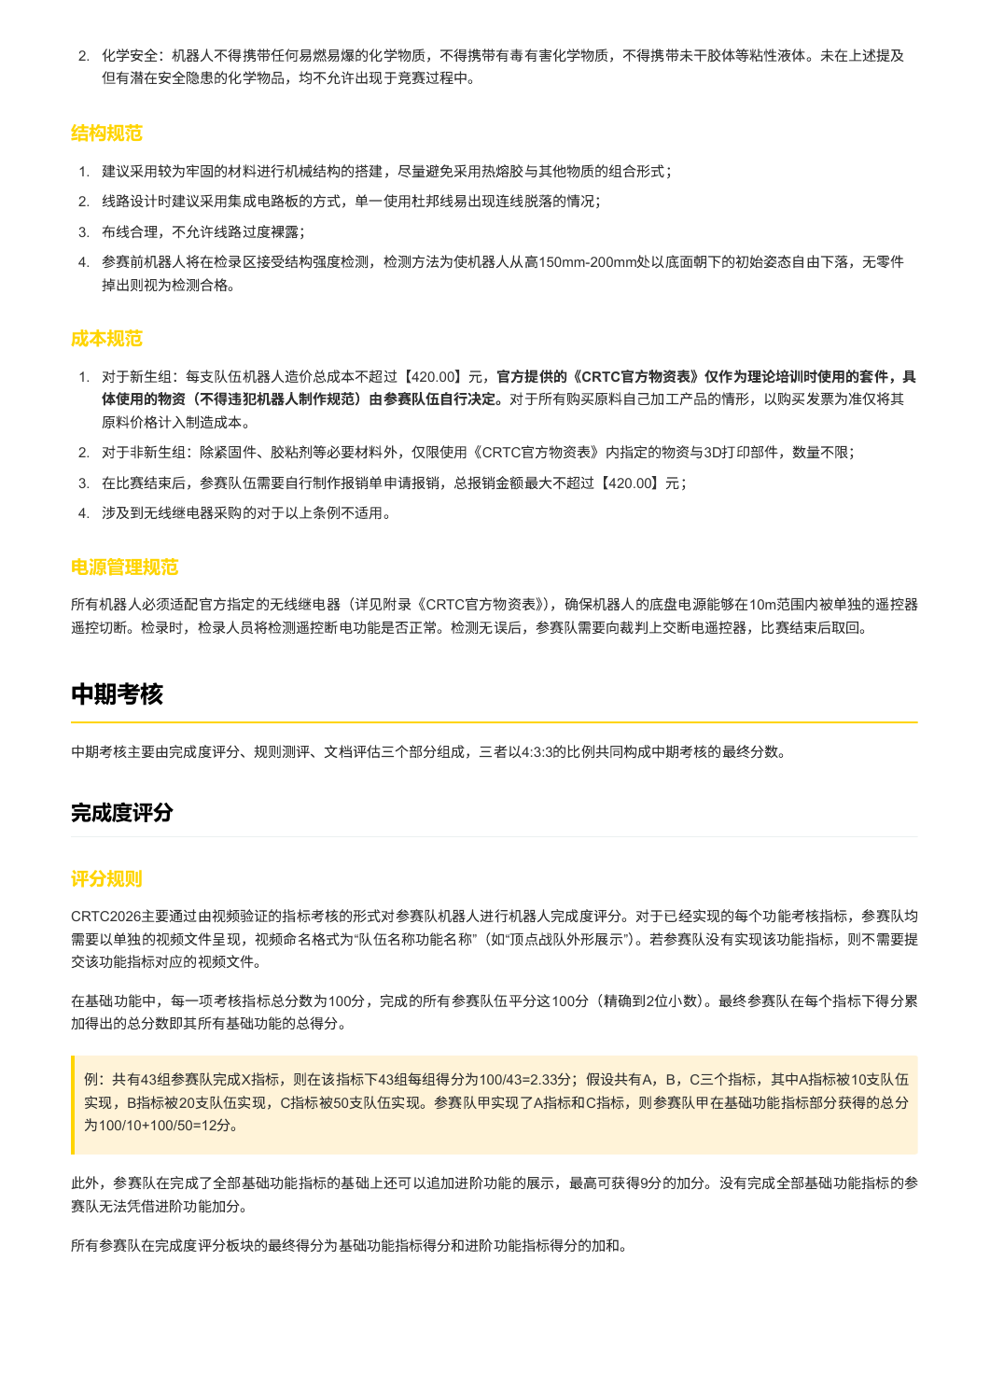
tmp/sources/rule-07.png
