Seroliya/zqcs-team-robotics/tmp/sources/rule-08.png

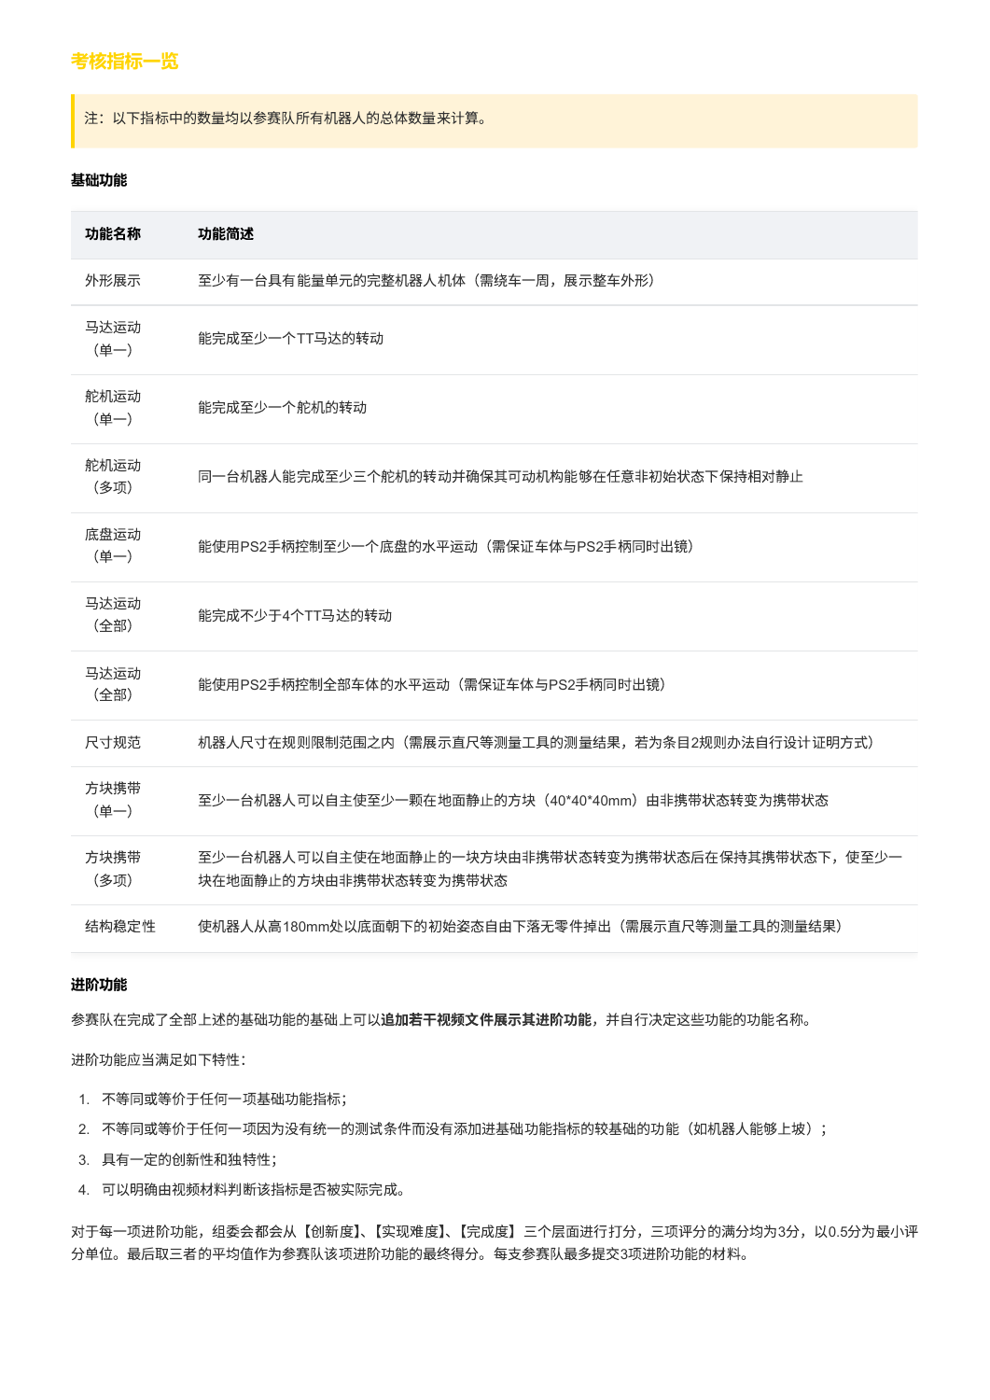
tmp/sources/rule-08.png
