Seroliya/zqcs-team-robotics/tmp/sources/rule-18.png

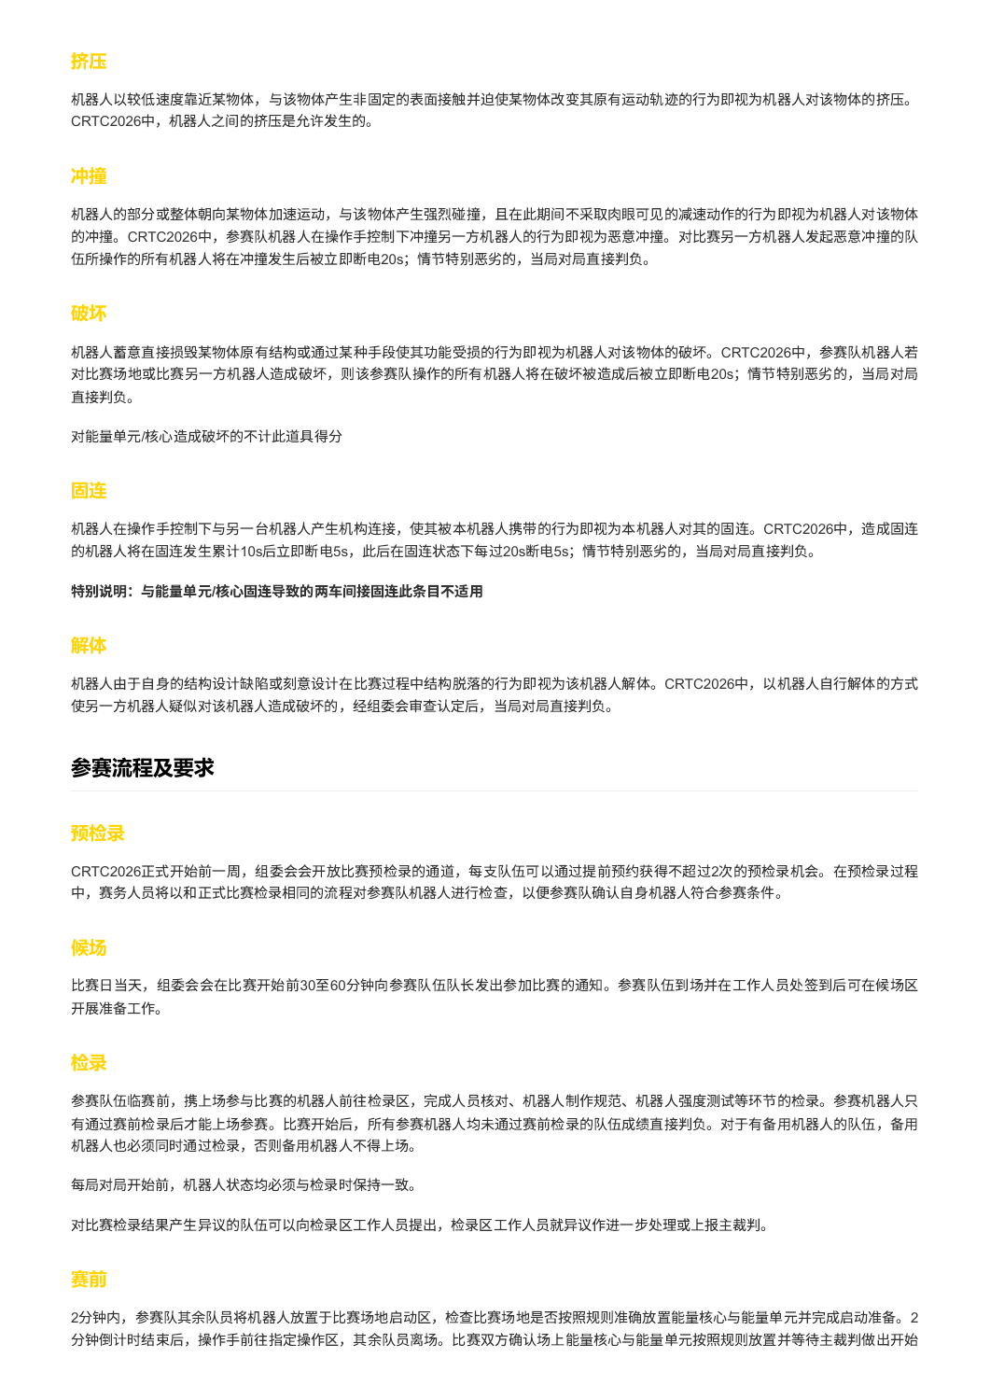
tmp/sources/rule-18.png
