Seroliya/zqcs-team-robotics/tmp/sources/strategy-rule-19.png

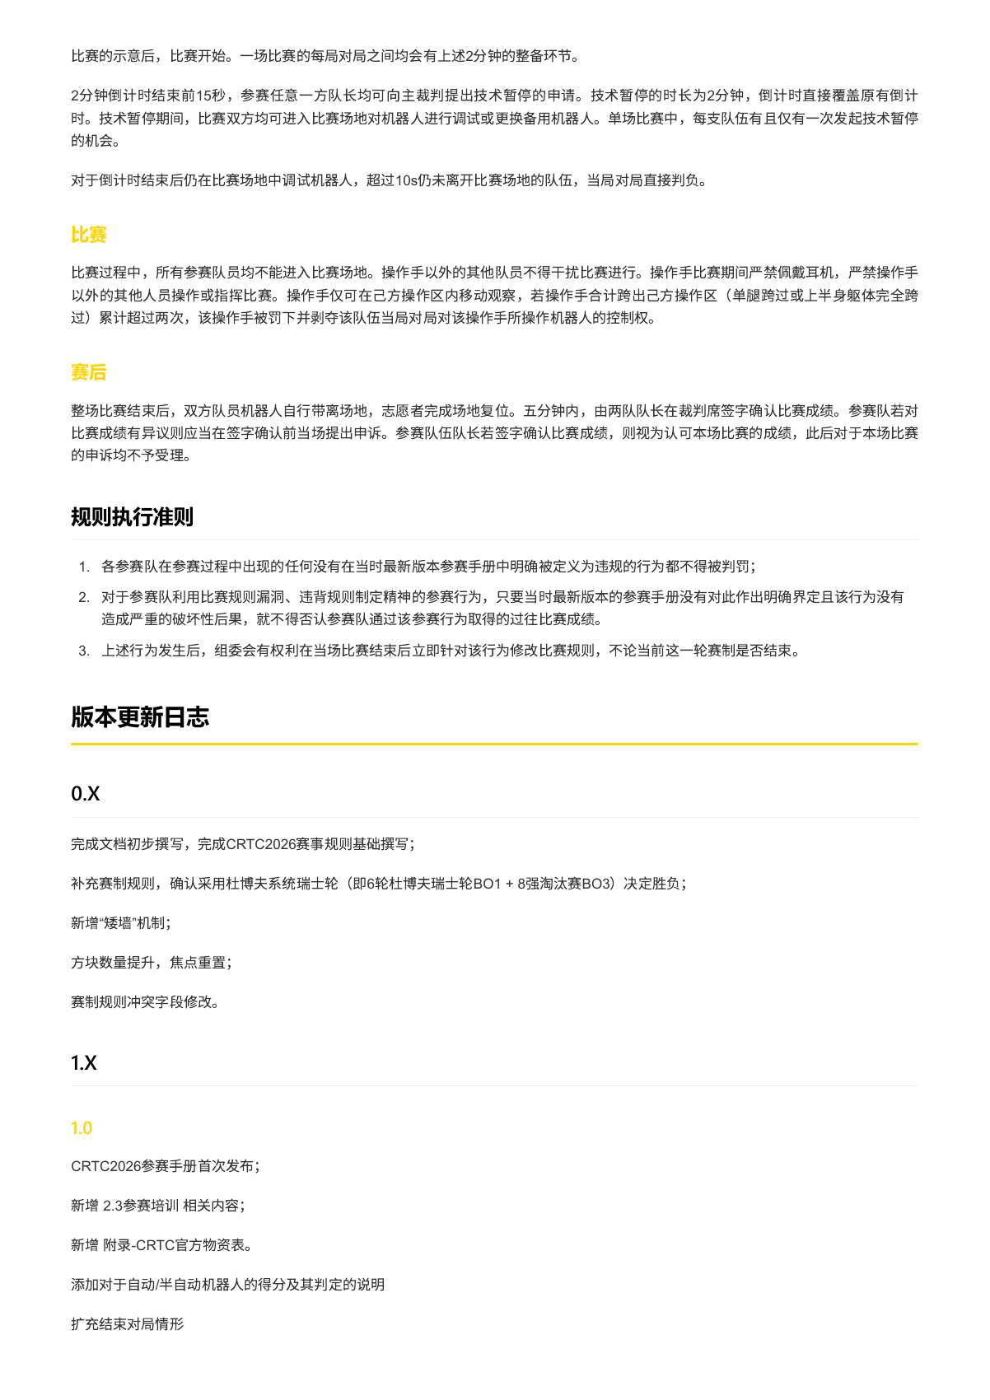
tmp/sources/strategy-rule-19.png
