Seroliya/zqcs-team-robotics/信号接线图.png

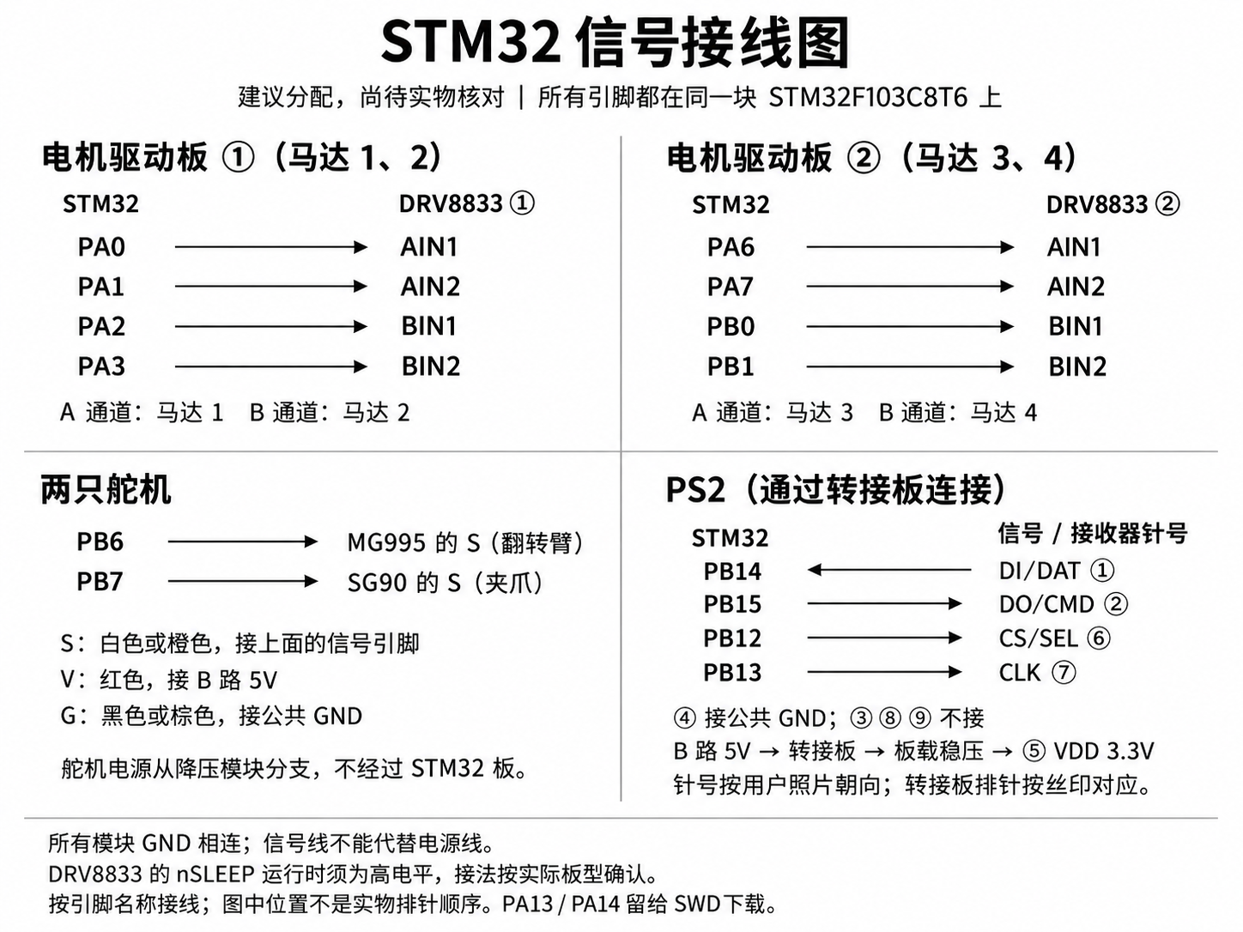
信号接线图.png
