Seroliya/zqcs-team-robotics/sample-mecanum-car-study/tests/test_motor_tuning.c

#include <assert.h>
#include <stdio.h>
#include <stdlib.h>
#include <stdint.h>
#include "motor.h"
#include "motor_tuning.h"
#include "mock_hardware.h"

static int output(unsigned wheel)
{ return (int)mock_ccr[wheel * 2] - mock_ccr[wheel * 2 + 1]; }
static void advance(uint32_t ms)
{ mock_millis += ms; motor_update(); }
static void stopped(void)
{
    unsigned wheel;
    for (wheel = 0; wheel < 4; wheel++) assert(output(wheel) == 0);
}
static void forward(int compare)
{
    assert(abs(output(0) + compare) <= 1 && abs(output(1) + compare) <= 1);
    assert(abs(output(2) - compare) <= 1 && abs(output(3) - compare) <= 1);
}
static void settle(void)
{
    unsigned i;
    for (i = 0; i < 120; i++) advance(10);
}

static void test_ramp(void)
{
    unsigned i;
    motor_init(); stopped();
    motor(0,128,128); stopped();
    advance(0); stopped();
    advance(10); forward(0); /* S曲线前10ms不足1个CCR计数 */
    advance(10); forward(2);
    for (i = 0; i < 47; i++) advance(10);
    forward(3599); /* 五次曲线490ms尚未满幅 */
    advance(10);
    forward(3600);
    motor(64,128,128); advance(10); forward(3240); /* 减少10% */
    settle(); forward(1351); /* 左杆25%三次混合后的目标 */
    motor(128,128,128); stopped(); /* 松杆立即撤输出，不等减速斜坡 */
    advance(500); stopped();

    motor_init(); motor_set_strafe_percent(85,100); motor(0,0,0);
    for (i=0; i<10; i++) advance(10);
    assert(abs(output(0) + 73) <= 1 && abs(output(1) + 73) <= 1);
    assert(abs(output(2) - 208) <= 1 && abs(output(3) + 62) <= 1);

    motor_init(); motor(0,128,128); advance(1000);
    forward(2); /* 大间隔只按20ms推进曲线，不突然全速 */
    motor_set_speed_percent(0); stopped(); advance(50); stopped();
    puts("PASS: 0.5s full-scale ramp, common four-wheel ratio, immediate stop, delayed-loop cap");
}

static void test_reverse(void)
{
    unsigned i;
    motor_init(); motor(0,128,128); settle(); forward(3600);
    motor(255,128,128); advance(10); forward(3240);
    for (i = 0; i < 35 && output(0) != 0; i++)
    {
        advance(10);
        assert(output(0) <= 0 && output(1) <= 0);
        assert(output(2) >= 0 && output(3) >= 0);
    }
    stopped();
    advance(MOTOR_REVERSAL_COAST_MS - 1); stopped();
    advance(1); advance(20);
    assert(output(0) > 0 && output(1) > 0 && output(2) < 0 && output(3) < 0);
    settle(); forward(-3600);

    /* 快速“松杆再反推”也不能绕过零输出等待；重复stop不延长等待。 */
    motor_stop(); advance(10); motor(0,128,128); advance(0); stopped();
    motor_stop(); motor(0,128,128);
    advance(MOTOR_REVERSAL_COAST_MS - 11); stopped();
    advance(1); advance(20); assert(output(0) < 0);
    motor_stop(); advance(1000); stopped();

    /* 毫秒计数回绕不破坏换向等待。 */
    mock_millis = UINT32_MAX - 30U;
    motor_init(); motor(0,128,128); advance(20);
    motor_stop(); motor(255,128,128);
    advance(MOTOR_REVERSAL_COAST_MS - 1); stopped();
    advance(1); advance(20); assert(output(0) > 0);
    puts("PASS: reversal deceleration/coast, neutral bypass prevention, timer wrap");
}

static void test_calibration(void)
{
    motor_calibration_t calibration = {80, 60, 20, 30};
    motor_init();
    motor_set_strafe_percent(100,100); /* 对称基线下验证斜移数学零轮 */
    assert(motor_set_calibration(0, &calibration));
    motor(64,128,128); settle();
    assert(abs(output(0) + 1081) <= 1 && abs(output(2) - 1351) <= 1);
    motor(119,128,128); settle(); assert(abs(output(0) + 720) <= 1);
    motor(137,128,128); settle(); assert(abs(output(0) - 1080) <= 1);
    motor(255,128,128); settle(); assert(abs(output(0) - 2160) <= 1);
    motor_set_speed_percent(10); motor(119,128,128); settle();
    assert(abs(output(0)) <= 360); /* 20%最低PWM也不能越过10%上限 */
    motor(0,0,128); settle(); assert(output(0) == 0); /* 数学零轮不能起转 */
    motor(128,128,128); stopped();
    assert(!motor_set_calibration(4, &calibration));
    assert(!motor_set_calibration(0, NULL));
    calibration.forward_min_percent = 101;
    assert(!motor_set_calibration(0, &calibration));

    motor_init(); motor(0,128,128); settle(); forward(3600);
    motor_set_speed_percent(60); forward(2160);
    assert(!motor_output_above_percent(60));
    motor_set_speed_percent(100); motor(0,128,128); advance(10);
    assert(motor_output_above_percent(60));
    motor_stop(); assert(!motor_output_above_percent(0));
    puts("PASS: mechanical forward/reverse trim, PWM floor/cap, zero wheel, actual-output LED threshold");
}

static void test_strafe_trial(void)
{
    unsigned wheel;
    int left[4];
    /* 前100/后95，S曲线40ms约达前0.45%、后0.43%。 */
    motor_init();
    assert(motor_get_strafe_front_percent() == 100 && motor_get_strafe_rear_percent() == 95);
    motor(128,0,128);
    advance(20); advance(20);
    assert(abs(output(0) - 15) <= 1 && abs(output(1) + 15) <= 1);
    assert(abs(output(2) - 16) <= 1 && abs(output(3) + 16) <= 1);
    settle();
    assert(abs(output(0) - 3420) <= 1 && abs(output(1) + 3420) <= 1);
    assert(output(2) == 3600 && output(3) == -3600);
    for (wheel = 0; wheel < 4; wheel++) left[wheel] = output(wheel);
    motor(128,255,128); settle();
    for (wheel = 0; wheel < 4; wheel++) assert(abs(output(wheel) + left[wheel]) <= 1);
    motor_set_speed_percent(50); motor(128,0,128); settle();
    assert(abs(output(0) - 1710) <= 1 && abs(output(1) + 1710) <= 1);
    assert(output(2) == 1800 && output(3) == -1800);
    motor_set_speed_percent(100); motor(0,0,128); settle();
    /* F=L=1，机械混合[0.05,1.95,2,0]归一化后补后轮极性。 */
    assert(abs(output(0) + 90) <= 1 && abs(output(1) + 3510) <= 1);
    assert(output(2) == 3600 && output(3) == 0);
    motor(128,128,128); stopped();
    /* 该补偿不降低纯前进/后退或纯旋转的前轮分量。 */
    motor_set_speed_percent(100); motor(0,128,128); settle(); forward(3600);
    motor(255,128,128); settle(); forward(-3600);
    motor(128,128,0); settle();
    assert(output(0) == -3600 && output(1) == 3600);
    assert(output(2) == 3600 && output(3) == -3600);
    motor_stop(); stopped(); advance(200); stopped();
    puts("PASS: front100/rear95 default, strafe/diagonal ratio, bilateral symmetry, cap, unchanged forward/back/yaw");
}

int main(void)
{
    test_ramp(); test_reverse(); test_calibration(); test_strafe_trial();
    return 0;
}
