Seroliya/zqcs-team-robotics/sample-mecanum-car-study/hardware/Inc/sys.h

/**			                                                    
		   ____                    _____ _______ _____       XTARK@塔克创新
		  / __ \                  / ____|__   __|  __ \ 
		 | |  | |_ __   ___ _ __ | |       | |  | |__) |
		 | |  | | '_ \ / _ \ '_ \| |       | |  |  _  / 
		 | |__| | |_) |  __/ | | | |____   | |  | | \ \ 
		  \____/| .__/ \___|_| |_|\_____|  |_|  |_|  \_\
				| |                                     
				|_|                OpenCTR   机器人控制器
									 
  ****************************************************************************** 
  *           
  * 版权所有： XTARK@塔克创新  版权所有，盗版必究
  * 公司网站： www.xtark.cn   www.tarkbot.com
  * 淘宝店铺： https://xtark.taobao.com  
  * 塔克微信： 塔克创新（关注公众号，获取最新更新资讯）
  *      
  ******************************************************************************
  * @作  者  塔克创新团队
  * @内  容  系统配置相关
  *
  ******************************************************************************
  */

#ifndef __SYS_H
#define __SYS_H

/* Includes ------------------------------------------------------------------*/	 
#include "stm32f10x.h"

///************** 位带操作，实现类51GPIO控制*********************************/
////IO口操作宏定义
#define BITBAND(addr, bitnum) ((addr & 0xF0000000)+0x2000000+((addr &0xFFFFF)<<5)+(bitnum<<2)) 
#define MEM_ADDR(addr)  *((volatile unsigned long  *)(addr)) 
#define BIT_ADDR(addr, bitnum)   MEM_ADDR(BITBAND(addr, bitnum))

//IO口地址映射
#define GPIOA_ODR_Addr    (GPIOA_BASE+12) //0x4001080C 
#define GPIOB_ODR_Addr    (GPIOB_BASE+12) //0x40010C0C 
#define GPIOC_ODR_Addr    (GPIOC_BASE+12) //0x4001100C 
#define GPIOD_ODR_Addr    (GPIOD_BASE+12) //0x4001140C 
#define GPIOE_ODR_Addr    (GPIOE_BASE+12) //0x4001180C 
#define GPIOF_ODR_Addr    (GPIOF_BASE+12) //0x40011A0C    
#define GPIOG_ODR_Addr    (GPIOG_BASE+12) //0x40011E0C    

#define GPIOA_IDR_Addr    (GPIOA_BASE+8) //0x40010808 
#define GPIOB_IDR_Addr    (GPIOB_BASE+8) //0x40010C08 
#define GPIOC_IDR_Addr    (GPIOC_BASE+8) //0x40011008 
#define GPIOD_IDR_Addr    (GPIOD_BASE+8) //0x40011408 
#define GPIOE_IDR_Addr    (GPIOE_BASE+8) //0x40011808 
#define GPIOF_IDR_Addr    (GPIOF_BASE+8) //0x40011A08 
#define GPIOG_IDR_Addr    (GPIOG_BASE+8) //0x40011E08 
 
//IO口操作,只对单一的IO口!确保n的值小于16!
#define PAout(n)   BIT_ADDR(GPIOA_ODR_Addr,n)  //输出 
#define PAin(n)    BIT_ADDR(GPIOA_IDR_Addr,n)  //输入 

#define PBout(n)   BIT_ADDR(GPIOB_ODR_Addr,n)  //输出 
#define PBin(n)    BIT_ADDR(GPIOB_IDR_Addr,n)  //输入 

#define PCout(n)   BIT_ADDR(GPIOC_ODR_Addr,n)  //输出 
#define PCin(n)    BIT_ADDR(GPIOC_IDR_Addr,n)  //输入 

#define PDout(n)   BIT_ADDR(GPIOD_ODR_Addr,n)  //输出 
#define PDin(n)    BIT_ADDR(GPIOD_IDR_Addr,n)  //输入 

#define PEout(n)   BIT_ADDR(GPIOE_ODR_Addr,n)  //输出 
#define PEin(n)    BIT_ADDR(GPIOE_IDR_Addr,n)  //输入

#define PFout(n)   BIT_ADDR(GPIOF_ODR_Addr,n)  //输出 
#define PFin(n)    BIT_ADDR(GPIOF_IDR_Addr,n)  //输入

#define PGout(n)   BIT_ADDR(GPIOG_ODR_Addr,n)  //输出 
#define PGin(n)    BIT_ADDR(GPIOG_IDR_Addr,n)  //输入

///************** 位带操作，实现类51GPIO控制*********************************/

//JTAG模式设置定义
#define JTAG_SWD_DISABLE   0X02
#define SWD_ENABLE         0X01
#define JTAG_SWD_ENABLE    0X00

//接口函数
void JTAG_Set(uint8_t mode);  //JTAG模式设置

#endif 

/******************* (C) 版权 2023 XTARK **************************************/
